Fabienrortais/cz/openchess-redesign/README.md

# OpenChess PCB redesign

A complete, single-PCB redesign of the OpenChess smart chess board
(https://joojoooo.github.io/OpenChess/) that keeps **100 % firmware
compatibility** with upstream (including the pre-built binaries), while
replacing the hand-wired "plastic PCB" + perfboard with one assembled board.

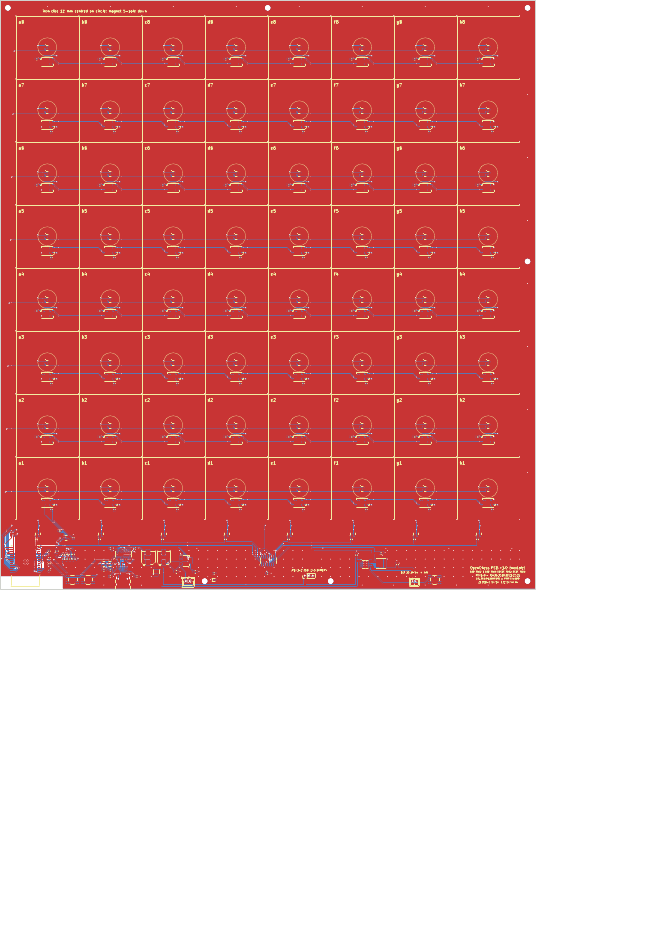
[picture p1: openchess-redesign/docs/img/pcb-overview.png]
overview


## What is on the board

- 8 x 8 squares, **40 mm pitch** (parametric), board 340 x 374 mm, 2 layers.
- Per square: one SOT-23 Hall switch at the square centre (under a 12 mm iron
  disc, silkscreen circle marks it), one WS2812B 5050 LED 9 mm below the
  centre, one 100 nF decoupling cap.
- Column drive: 74HCT595 -> 8 x 1k -> 8 x S8550 PNP high-side switches, one
  under each file, feeding switched +5V up a dedicated trace (same scheme as
  upstream, `SR_INVERT_OUTPUTS = PNP`).
- Rows: sensor open-collector outputs wired-OR per rank, 10k pull-up to 3.3 V,
  straight to the ESP32 GPIOs used by the upstream defaults.
- Controller strip (bottom 42 mm): ESP32-WROOM-32E, CH340C USB-UART with the
  DevKitC auto-reset circuit, RESET/BOOT buttons, AMS1117-3.3, USB-C
  (5 V/3 A, 5.1k CC pull-downs, 3 A polyfuse), optional JST-XH 5 V/4 A input,
  2 x 470 uF bulk, 74AHCT1G125 level shifter for the LED data.
- Power distribution: a 4 mm +5V bus along the strip (B.Cu) and a 2 mm vertical
  +5V bus per file; GND pours on both layers stitched with vias at every square
  corner.
- GPIO map = upstream defaults, so the firmware needs no changes:
  LED IO32, SR SER IO33, SRCLK IO14, RCLK IO26, rows IO4,16,17,18,19,21,22,23.

## Optional battery (both variants)

An IP5306 power-bank IC (Injoinic, LCSC C181692) charges a single Li-ion /
LiPo cell from the USB-C input (2.1 A) and boosts it to 5 V (2.4 A max) for
the board. It is selected with the 3-pin jumper **JP1**:

| JP1 | Bus fed from | Use |
|---|---|---|
| 1-2 | fuse output (USB-C or J2 directly) | no battery fitted; U6/L1/C77-C79/J5/SW3 can be left unpopulated |
| 2-3 | IP5306 VOUT (battery boost, pass-through while charging) | battery fitted on J5 (JST-PH 2.0 mm, + on pin 1) |

Without a battery: use the `-nobattery` BOM/CPL files (block unpopulated),
jumper JP1 1-2, and power through USB-C or J2 as on a board without the block.
SW3 is the IP5306 key (short press on, long press off, it also turns off by
itself below about 45 mA, which the ESP32 never reaches). Power budget: the
boost delivers 2.4 A, so with the battery keep the LED brightness moderate
(all 64 LEDs full white need 3.8 A); a 3000 mAh cell runs the board for
roughly 6-8 h of normal play. Set `OPENCHESS_BATTERY=0` before building to
remove the block entirely.

## Two variants

| Variant | Controller | Output folders | Use when |
|---|---|---|---|
| `module` (default) | ESP32-WROOM-32E soldered on the board, CH340C USB-UART, AMS1117-3.3, RESET/BOOT buttons | `hardware/`, `manufacturing/`, `docs/img/` | You want one fully assembled board from JLCPCB/PCBWay. |
| `nodemcu` | Two 19-pin sockets for a plug-in 38-pin ESP32 dev board (NodeMCU-32S, ESP32-DevKitC V4, ...). USB-C is power only; flashing is done through the dev board's own USB. | `hardware-nodemcu/`, `manufacturing-nodemcu/`, `docs/img-nodemcu/` | You already have a NodeMCU / DevKitC. Strip is 56 mm tall (board 340 x 388 mm). |

NodeMCU variant notes:

- The dev board plugs in with its **antenna to the left and USB to the right**
  (silkscreen says so). Bottom-left pin is 3V3, bottom-right pin is 5V; the
  top row carries GND, IO23, IO22, TX, RX, IO21, GND, IO19, IO18, IO5, IO17,
  IO16, IO4, ... which is the pin order of both the NodeMCU-32S and the
  Espressif DevKitC V4. Check the silkscreen of your board: 3V3 and 5V must
  land on those two corner pins. If a signal pin differs, that is harmless:
  every signal GPIO is configurable in the OpenChess WebUI.
- `DEV_ROW_SPACING` in `design.py` is the distance between the two pin rows:
  22.86 mm (0.9") for the NodeMCU-32S, 25.4 mm (1.0") for the DevKitC V4.
  Measure yours centre-to-centre before ordering.
- No copper pour is placed under the antenna end of the dev board.
- Power the board from the USB-C or J2 (5 V/4 A). Powering only through the
  dev board's micro-USB works for testing but its diode limits LED current.

Build one variant with `VARIANTS=nodemcu ./build.sh /path/to/freerouting.jar`
or set `OPENCHESS_VARIANT=nodemcu` when running the tools by hand.

Folder layout:

```
openchess-redesign/
  AUDIT.md           audit of the upstream project
  README.md          this file
  ORDERING.md        how to order at JLCPCB / PCBWay, cost notes, assembly notes
  hardware/          KiCad project of the module variant (+ DRC report); hardware-nodemcu/ for the dev-board variant
  manufacturing/     gerber zip, drill, JLCPCB BOM + CPL, BOM.md, PDFs (manufacturing-nodemcu/ likewise)
  tools/             generators (everything above is produced from design.py)
  docs/img/          previews
  build.sh           regenerate everything
```

## Regenerating / changing the design

Everything is generated from `tools/design.py` (parts, nets, placement) by
Python scripts that drive KiCad's `pcbnew` module and `kicad-cli`.

KiCad versions: the files were produced with KiCad 7.0.11 (the version
installable in the build container) and use the KiCad 7 file format, which
KiCad 8, 9 and 10 open directly and migrate on save. The scripts detect the
installed version (library paths, API differences, `kicad-cli pcb drc` on 8+)
so you can rebuild with your current KiCad 10 install; the first save from
KiCad 10 will convert the project to the KiCad 10 format.
The matrix routing is scripted; only the controller strip is auto-routed with
Freerouting.

```sh
sudo apt install kicad kicad-symbols kicad-footprints xvfb default-jre   # or any KiCad 8/9/10 install
# Freerouting 1.9.0 jar from https://github.com/freerouting/freerouting/releases
./build.sh /path/to/freerouting.jar
```

Things you will most likely want to change, all at the top of `design.py`:

| Parameter | Default | Note |
|---|---|---|
| `PITCH` | 40.0 mm | Square pitch. 33.33 matches the upstream LED-strip pitch; 45-50 mm for club-size pieces. Board size follows. |
| `SENSOR` | HX3144ESO, pins VCC=1 OUT=2 GND=3 | **Check the datasheet of the exact part you order**; SOT-23 "44E" parts differ between vendors. Any continuous-time open-collector Hall switch in SOT-23 works. |
| `GPIO` | upstream defaults | Only change if you also change the firmware pin config. |
| `STRIP_H`, `MARGIN` | 42 / 10 mm | Controller strip height, grid margin. |

The build verifies the schematic netlist against the model
(`tools/verify_netlist.py`), runs DRC (`tools/drc.py`) and writes
`hardware/openchess-board_drc.rpt`. Opening the project in KiCad and running
"Update PCB from schematic" should report nothing to change.

## Firmware setup on this board

1. Flash the upstream firmware (web flasher or PlatformIO) over the USB-C port
   (CH340C, hold BOOT if needed; the auto-reset circuit normally handles it).
2. In the WebUI "GPIO" section keep the defaults and set the shift-register
   output type to **PNP**.
3. Run the calibration (serial monitor, 115200 baud) once: it learns the LED
   order and the row/column mapping.

## Printable enclosure

`enclosure/enclosure.scad` (OpenSCAD) builds a tray, a 4-piece top plate and a
2-piece controller-strip cover from the same parameters as the PCB
(`tools/gen_enclosure.py` writes `enc_params.scad` and renders the STLs into
`enclosure/stl/` for the module variant and `enclosure/stl-nodemcu/` for the
NodeMCU variant). Every piece is under 175 x 195 mm, so all fit a 256 mm bed
(Bambu A1 or similar):

| Part | Pieces | Print orientation / notes |
|---|---|---|
| `top_q00`, `top_q10`, `top_q01`, `top_q11` | 4 quadrants of the playing surface, 4 mm thick | Print playing face DOWN on the bed: the 12.4 mm iron-disc pockets and 9 mm LED pockets then open upwards and need no supports; 0.8 mm skin stays above each LED. Light/white filament lets the LEDs shine through. Grooves mark the squares, coordinates are engraved in the margins. |
| `tray_00` .. `tray_11` | 4 pieces of the base tray | Flat, no supports. M3 screws go up through the countersunk floor holes into the top plate. |
| `cover_0`, `cover_1` | 2 halves of the strip cover | Print top down. Openings for USB-C (in the tray wall), J2 cable, buttons/LED (module) or the dev board's USB (NodeMCU). |

Glue the quadrant joints (they fall on square edges) or add tape underneath.
Iron discs are glued into the pockets from below; magnets go in the pieces
with the S pole down, as upstream.

## Mechanical notes

- Top plate: anything 3-6 mm thick with a 12.2 mm x 1.2 mm pocket for the iron
  disc centred on each square and a window/diffuser over the LED (9 mm below
  centre). Four 160 x 160 mm printed quadrants fit a 256 mm printer bed.
- The ESP32 antenna overhangs the bottom edge by 6 mm with a copper keep-out
  around it; leave that area of the enclosure free of metal.
- Mounting holes: 7 x M3.

## DRC status

Both variants pass KiCad DRC with 0 errors and 0 unconnected items
(`hardware*/openchess-board*_drc.rpt`). The remaining entries in the reports
are warnings: "library footprint" notices (the headless build has no
fp-lib-table), silkscreen overlaps of reference designators, and a few
"track dangling" notes where the autorouter joined a pre-routed stub mid-way.

Build pipeline per variant: `gen_sch.py` -> `verify_netlist.py` -> `gen_pcb.py`
(scripted matrix routing + pre-routed power/USB/ground stubs) -> `route.py`
(Freerouting for the strip, own `.ses` importer) -> `gnd_repair.py` (adds vias
for ground pour islands, bridges split ground clusters) -> `drc.py` ->
`export.py`. `reroute_nets.py NET...` locks everything else and lets the
router redo single nets.

## Known limitations / to verify

- LCSC numbers were filled from memory and are flagged; verify each one in
  the JLCPCB parts library before ordering (see `ORDERING.md`).
- Rotations in the CPL follow KiCad's convention; check the JLCPCB placement
  preview and rotate SOT-23 / SOIC parts if their preview shows pin 1 wrong.
- 2-layer power distribution is sized for about 4 A total LED current; keep
  the firmware brightness sensible or feed 5 V through J2.
