Fabienrortais/cz/openchess-redesign/docs/img-nodemcu/pcb-controller-strip.png

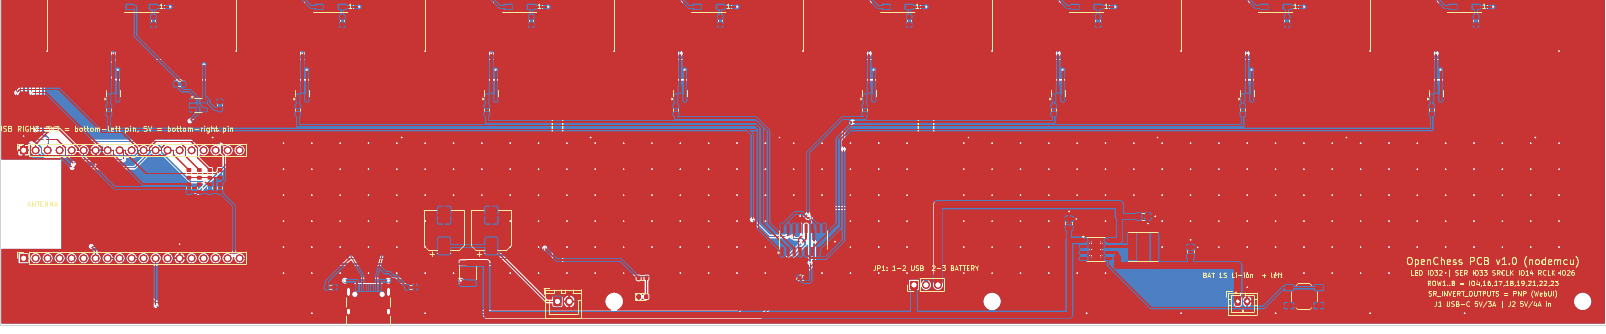
openchess-redesign/docs/img-nodemcu/pcb-controller-strip.png
