Fabienrortais/cz/openchess-redesign/docs/img-nodemcu/pcb-overview.png

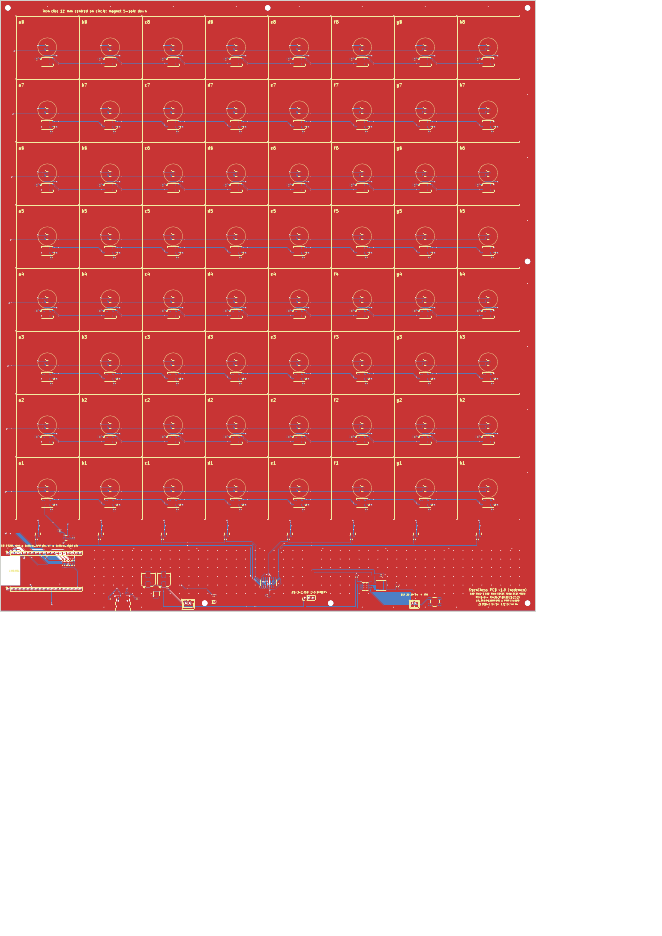
openchess-redesign/docs/img-nodemcu/pcb-overview.png
