Fabienrortais/cz/openchess-redesign/docs/img-nodemcu/pcb-square-detail.png

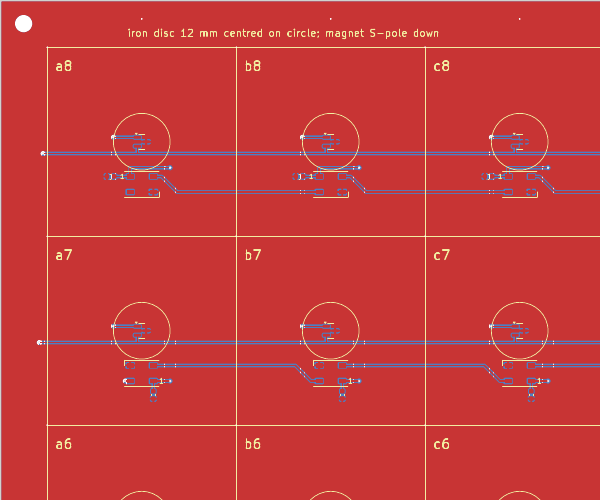
openchess-redesign/docs/img-nodemcu/pcb-square-detail.png
