Fabienrortais/cz/openchess-redesign/docs/img-nodemcu/schematic.png

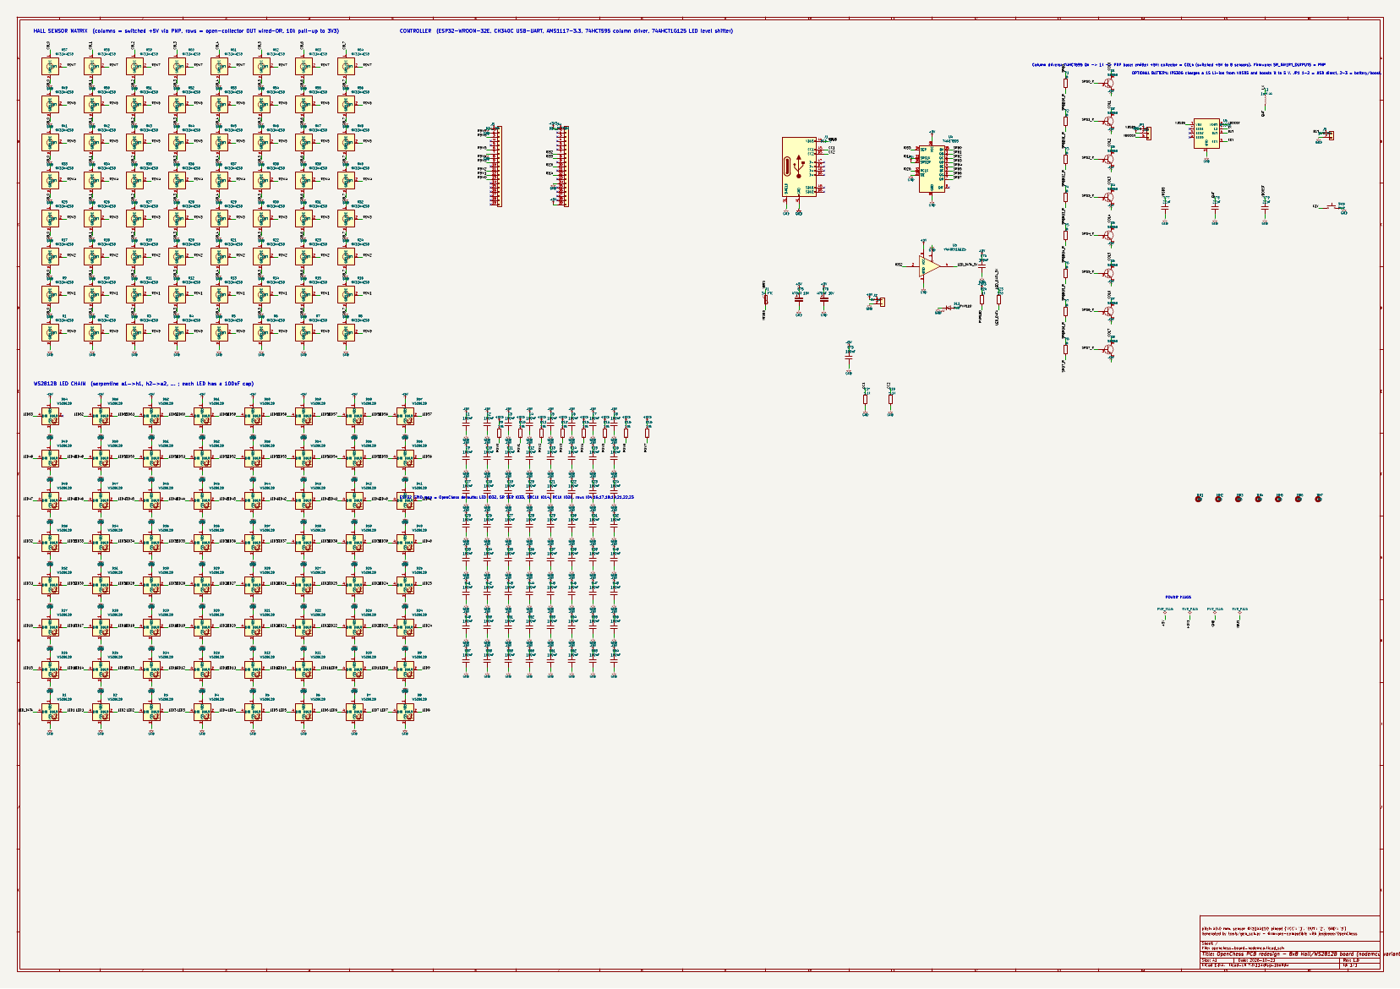
openchess-redesign/docs/img-nodemcu/schematic.png
