Fabienrortais/cz/openchess-redesign/docs/img/pcb-controller-strip.png

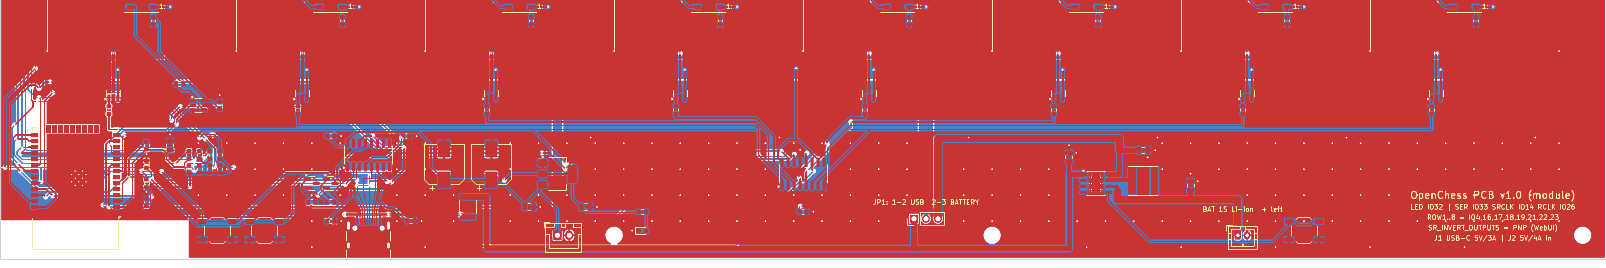
openchess-redesign/docs/img/pcb-controller-strip.png
