Fabienrortais/cz/openchess-redesign/manufacturing-nodemcu/BOM.md

# Bill of materials (generated by tools/export.py)

LCSC numbers marked (verify) were not confirmed on jlcpcb.com; the OPTIONAL battery block lines can be left unpopulated (see ORDERING.md).

| Qty | Designators | Value | MPN / note | Footprint | LCSC | Description |
|---|---|---|---|---|---|---|
| 64 | H1..H64 (64) | HX3144ESO | HX3144ESO | SOT-23 | C558880 | Hall switch |
| 64 | D1..D64 (64) | WS2812B | WS2812B-B/T | LED_WS2812B_PLCC4_5.0x5.0mm_P3.2mm | C2761795 | RGB LED |
| 64 | C1..C64 (64) | 100nF | CL10B104KB8NNNC | C_0603_1608Metric | C14663 | LED decoupling |
| 1 | J3 | DEV_TOP | 1x19 female header 2.54 mm | PinSocket_1x19_P2.54mm_Vertical | TBD | Dev board socket, top row (GND,23,22,TX,RX,21,GND,19,18,5,17,16,4,0,2,15,SD1,SD0,CLK) |
| 1 | J4 | DEV_BOTTOM | 1x19 female header 2.54 mm | PinSocket_1x19_P2.54mm_Vertical | TBD | Dev board socket, bottom row (3V3,EN,VP,VN,34,35,32,33,25,26,27,14,12,GND,13,SD2,SD3,CMD,5V) |
| 8 | R9..R16 (8) | 10k |  | R_0603_1608Metric | C25804 | ROW0 pull-up |
| 1 | U5 | 74AHCT1G125 | SN74AHCT1G125DBVR | SOT-23-5 | C7484 | WS2812B data level shifter |
| 2 | C74,C73 | 100nF |  | C_0603_1608Metric | C14663 | U5 decoupling |
| 1 | R23 | 330 | 330R 0603 (verify C23138) | R_0603_1608Metric | C23138 | LED data series |
| 1 | J1 | USB-C | TYPE-C-31-M-12 | USB_C_Receptacle_HRO_TYPE-C-31-M-12 | C165948 | USB-C receptacle 16P |
| 2 | R17,R18 | 5.1k |  | R_0603_1608Metric | C23186 | USB CC1 pull-down |
| 1 | F1 | 3A PTC | BSMD1812-300-16V (BHFUSE) or ASMD1812-300 C135366 | Fuse_1812_4532Metric | C883162 | Resettable fuse 3A hold (USB path) |
| 1 | U6 | IP5306 | IP5306 | HSOP-8-1EP_3.9x4.9mm_P1.27mm_EP2.41x3.1mm_ThermalVias | C181692 | OPTIONAL battery block: Li-ion charger (2.1 A) + 5 V boost (2.4 A), power-bank IC |
| 1 | L1 | 1uH 4A | SWPA6045S1R0NT (Sunlord) / CKCS6045-1uH/N C354627 / NR6045T1R0N - check land pattern | L_Taiyo-Yuden_NR-60xx | C96955 | OPTIONAL battery block: Boost inductor 1 uH, >= 4 A sat, 6x6 mm |
| 3 | C77,C78,C79 | 22uF |  | C_0805_2012Metric | C45783 | OPTIONAL battery block: IP5306 VIN cap |
| 1 | J5 | BATTERY | B2B-PH-K-S | JST_PH_B2B-PH-K_1x02_P2.00mm_Vertical | C131337 | OPTIONAL battery block: 1S Li-ion / LiPo battery, JST-PH 2.0 mm (+ on pin 1, check your pack!) |
| 1 | JP1 | PWR SEL | 1x3 pin header 2.54 mm + jumper cap | PinHeader_1x03_P2.54mm_Vertical | TBD | OPTIONAL battery block: Power select: 1-2 = USB direct (no battery), 2-3 = battery/boost (IP5306) |
| 1 | SW3 | PWR | TS-1187A-B-A-B | SW_SPST_TL3342 | C318884 | OPTIONAL battery block: IP5306 KEY: short press = boost on, long press = off |
| 1 | J2 | 5V IN | B2B-XH-A | JST_XH_B2B-XH-A_1x02_P2.50mm_Vertical | C158012 | External 5V/4A input (optional, bypasses fuse) |
| 2 | C75,C76 | 470uF 10V | RVT1C471M0810 470uF 16V D8xL10 (verify) | CP_Elec_8x10 | C3341 | 5V bulk capacitor |
| 1 | DL1 | PWR |  | LED_0603_1608Metric | C72043 | Power LED (green) |
| 9 | R24..R8 (9) | 1k |  | R_0603_1608Metric | C21190 | Power LED series |
| 1 | U4 | 74HCT595 | 74HCT595D,112 (Nexperia) | SOIC-16_3.9x9.9mm_P1.27mm | C70468 | Column shift register (HCT = 3.3V-input compatible) |
| 8 | Q1..Q8 (8) | S8550 | S8550 2TY (PNP) | SOT-23 | C2147 | Column a high-side PNP switch |
