Fabienrortais/cz/openchess-redesign/manufacturing-nodemcu/openchess-board-nodemcu-bom-jlcpcb-nobattery.csv

Comment | Designator | Footprint | LCSC Part #
HX3144ESO | H1,H2,H3,H4,H5,H6,H7,H8,H9,H10,H11,H12,H13,H14,H15,H16,H17,H18,H19,H20,H21,H22,H23,H24,H25,H26,H27,H28,H29,H30,H31,H32,H33,H34,H35,H36,H37,H38,H39,H40,H41,H42,H43,H44,H45,H46,H47,H48,H49,H50,H51,H52,H53,H54,H55,H56,H57,H58,H59,H60,H61,H62,H63,H64 | SOT-23 | C558880
WS2812B | D1,D2,D3,D4,D5,D6,D7,D8,D9,D10,D11,D12,D13,D14,D15,D16,D17,D18,D19,D20,D21,D22,D23,D24,D25,D26,D27,D28,D29,D30,D31,D32,D33,D34,D35,D36,D37,D38,D39,D40,D41,D42,D43,D44,D45,D46,D47,D48,D49,D50,D51,D52,D53,D54,D55,D56,D57,D58,D59,D60,D61,D62,D63,D64 | LED_WS2812B_PLCC4_5.0x5.0mm_P3.2mm | C2761795
100nF | C1,C2,C3,C4,C5,C6,C7,C8,C9,C10,C11,C12,C13,C14,C15,C16,C17,C18,C19,C20,C21,C22,C23,C24,C25,C26,C27,C28,C29,C30,C31,C32,C33,C34,C35,C36,C37,C38,C39,C40,C41,C42,C43,C44,C45,C46,C47,C48,C49,C50,C51,C52,C53,C54,C55,C56,C57,C58,C59,C60,C61,C62,C63,C64 | C_0603_1608Metric | C14663
DEV_TOP | J3 | PinSocket_1x19_P2.54mm_Vertical
DEV_BOTTOM | J4 | PinSocket_1x19_P2.54mm_Vertical
10k | R9,R10,R11,R12,R13,R14,R15,R16 | R_0603_1608Metric | C25804
74AHCT1G125 | U5 | SOT-23-5 | C7484
100nF | C74,C73 | C_0603_1608Metric | C14663
330 | R23 | R_0603_1608Metric | C23138
USB-C | J1 | USB_C_Receptacle_HRO_TYPE-C-31-M-12 | C165948
5.1k | R17,R18 | R_0603_1608Metric | C23186
3A PTC | F1 | Fuse_1812_4532Metric | C883162
PWR SEL | JP1 | PinHeader_1x03_P2.54mm_Vertical
5V IN | J2 | JST_XH_B2B-XH-A_1x02_P2.50mm_Vertical | C158012
470uF 10V | C75,C76 | CP_Elec_8x10 | C3341
PWR | DL1 | LED_0603_1608Metric | C72043
1k | R24,R1,R2,R3,R4,R5,R6,R7,R8 | R_0603_1608Metric | C21190
74HCT595 | U4 | SOIC-16_3.9x9.9mm_P1.27mm | C70468
S8550 | Q1,Q2,Q3,Q4,Q5,Q6,Q7,Q8 | SOT-23 | C2147
