Fabienrortais/cz/openchess-redesign/enclosure/stl-nodemcu/openchess-board-nodemcu-top_q01.stl

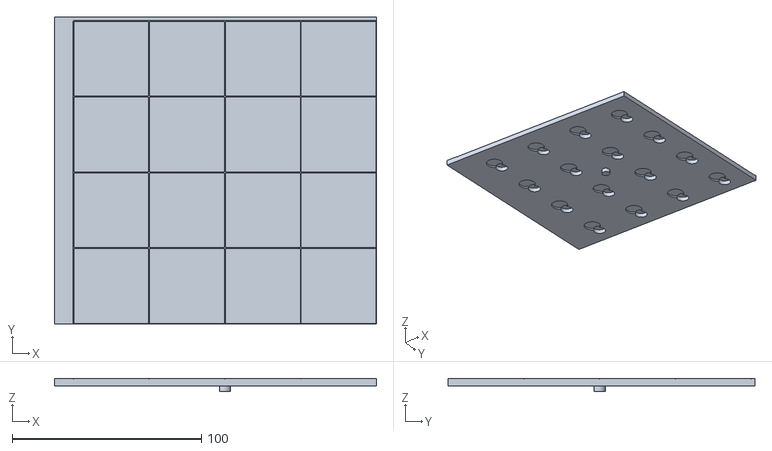
[picture p7: CAD file, 2026-10-21]
openchess-redesign/enclosure/stl-nodemcu/openchess-board-nodemcu-top_q01.stl
170.0 x 162.0 x 7.00
