Fabienrortais/cz/openchess-redesign/enclosure/stl/openchess-board-cover_0.stl

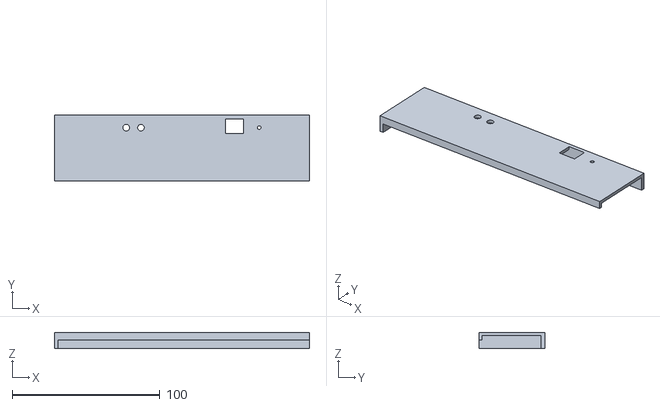
[picture p8: CAD file, 2026-10-21]
openchess-redesign/enclosure/stl/openchess-board-cover_0.stl
172.5 x 44.5 x 11.0
