Fabienrortais/cz/openchess-redesign/enclosure/stl-nodemcu/openchess-board-nodemcu-top_q10.stl

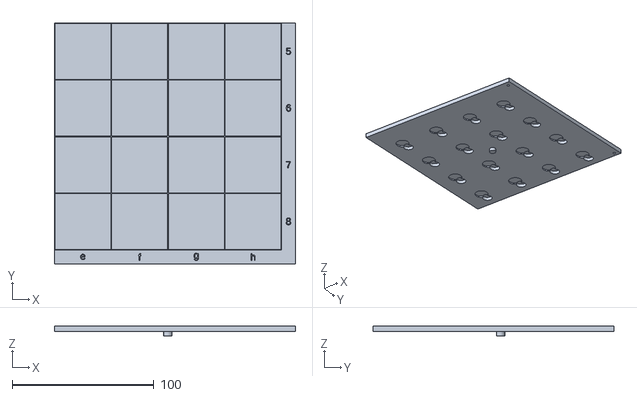
[picture p9: CAD file, 2026-10-21]
openchess-redesign/enclosure/stl-nodemcu/openchess-board-nodemcu-top_q10.stl
170.0 x 170.0 x 7.00
