Fabienrortais/cz/openchess-redesign/enclosure/stl/openchess-board-tray_11.stl

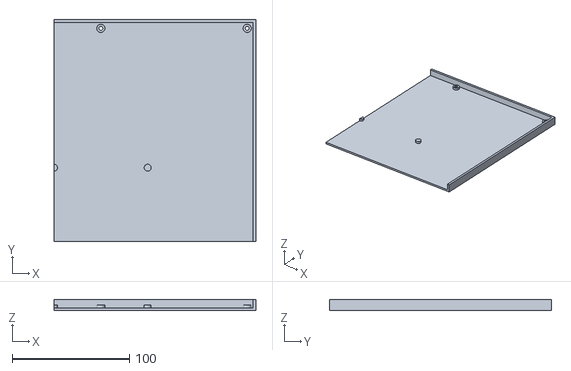
[picture p10: CAD file, 2026-10-21]
openchess-redesign/enclosure/stl/openchess-board-tray_11.stl
172.5 x 189.5 x 9.10
