Fabienrortais/cz/openchess-redesign/enclosure/stl-nodemcu/openchess-board-nodemcu-cover_0.stl

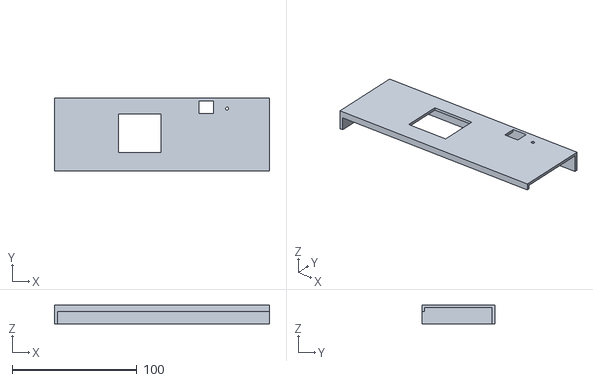
[picture p11: CAD file, 2026-10-21]
openchess-redesign/enclosure/stl-nodemcu/openchess-board-nodemcu-cover_0.stl
172.5 x 58.5 x 15.0
