Fabienrortais/cz/openchess-redesign/enclosure/stl-nodemcu/openchess-board-nodemcu-tray_01.stl

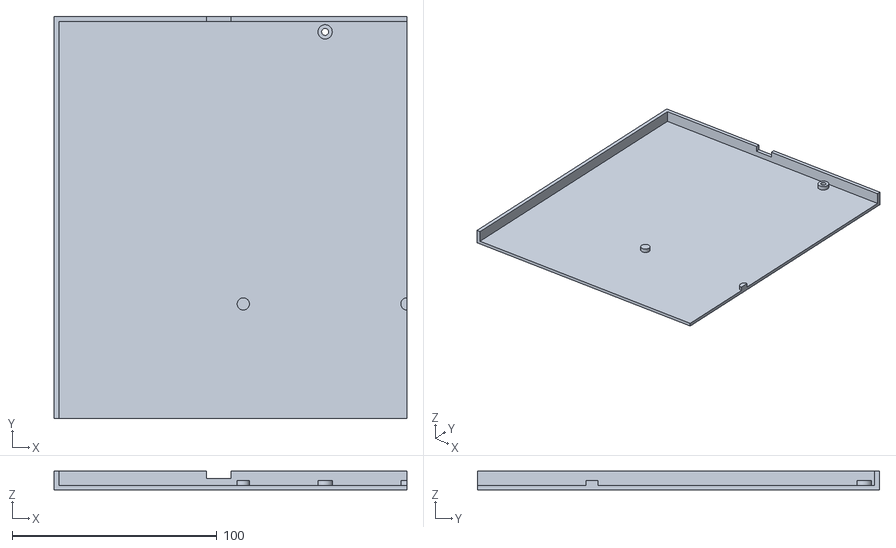
[picture p12: CAD file, 2026-10-21]
openchess-redesign/enclosure/stl-nodemcu/openchess-board-nodemcu-tray_01.stl
172.5 x 196.5 x 9.10
