Fabienrortais/cz/openchess-redesign/enclosure/enc_params.scad

VARIANT = "module";
W = 340.0; H = 374.0; STRIP_Y = 332.0;
PITCH = 40.0; GRID_X0 = 10.0; GRID_Y0 = 10.0; LED_DY = 9.0;
MH = [[5, 5], [170.0, 5], [335.0, 5], [335.0, 166.0], [335.0, 369.0], [210.0, 369.0], [130.0, 369.0]];
J1_X = 78.0; J2_X = 119.25; J2_Y = 369.0;
DL1_X = 136.0; DL1_Y = 368.0;
BATTERY = true;
J5_X = 263.0; J5_Y = 369.0; SW3_X = 276.0; SW3_Y = 368.0; JP1_X = 196.0; JP1_Y = 365.5;
SW1_X = 56.0; SW1_Y = 368.0; SW2_X = 46.0; SW2_Y = 368.0;
ANT_X0 = 4; ANT_X1 = 28;
COVER_INNER_H = 12;
DEV_USB_X0 = 0; DEV_USB_X1 = 0; DEV_USB_Y0 = 0; DEV_USB_Y1 = 0;
