Fabienrortais/cz/openchess-redesign/enclosure/stl-nodemcu/enc_params.scad

VARIANT = "nodemcu";
W = 340.0; H = 388.0; STRIP_Y = 332.0;
PITCH = 40.0; GRID_X0 = 10.0; GRID_Y0 = 10.0; LED_DY = 9.0;
MH = [[5, 5], [170.0, 5], [335.0, 5], [335.0, 166.0], [335.0, 383.0], [210.0, 383.0], [130.0, 383.0]];
J1_X = 78.0; J2_X = 119.25; J2_Y = 383.0;
DL1_X = 136.0; DL1_Y = 382.0;
BATTERY = true;
J5_X = 263.0; J5_Y = 383.0; SW3_X = 276.0; SW3_Y = 382.0; JP1_X = 196.0; JP1_Y = 379.5;
SW1_X = 0; SW1_Y = 0; SW2_X = 0; SW2_Y = 0;
ANT_X0 = 0; ANT_X1 = 0;
COVER_INNER_H = 16;
DEV_USB_X0 = 49.0; DEV_USB_X1 = 83.0; DEV_USB_Y0 = 347.0; DEV_USB_Y1 = 377.86;
