Fabienrortais/cz/(list of files, cad)

Other CAD files:
openchess-redesign/enclosure/stl-nodemcu/openchess-board-nodemcu-top_q11.stl
openchess-redesign/enclosure/stl/openchess-board-top_q01.stl
openchess-redesign/enclosure/stl/openchess-board-cover_1.stl
openchess-redesign/enclosure/stl/openchess-board-top_q10.stl
openchess-redesign/enclosure/stl-nodemcu/openchess-board-nodemcu-tray_11.stl
openchess-redesign/enclosure/stl/openchess-board-tray_10.stl
openchess-redesign/enclosure/stl-nodemcu/openchess-board-nodemcu-tray_00.stl
openchess-redesign/enclosure/stl/openchess-board-top_q00.stl
openchess-redesign/enclosure/stl-nodemcu/openchess-board-nodemcu-top_q00.stl
openchess-redesign/enclosure/stl/openchess-board-top_q11.stl
openchess-redesign/enclosure/stl/openchess-board-tray_00.stl
openchess-redesign/enclosure/stl-nodemcu/openchess-board-nodemcu-tray_10.stl
openchess-redesign/enclosure/stl/openchess-board-tray_01.stl
