Fabienrortais/cz/openchess-redesign/manufacturing-nodemcu/openchess-board-nodemcu-schematic.pdf

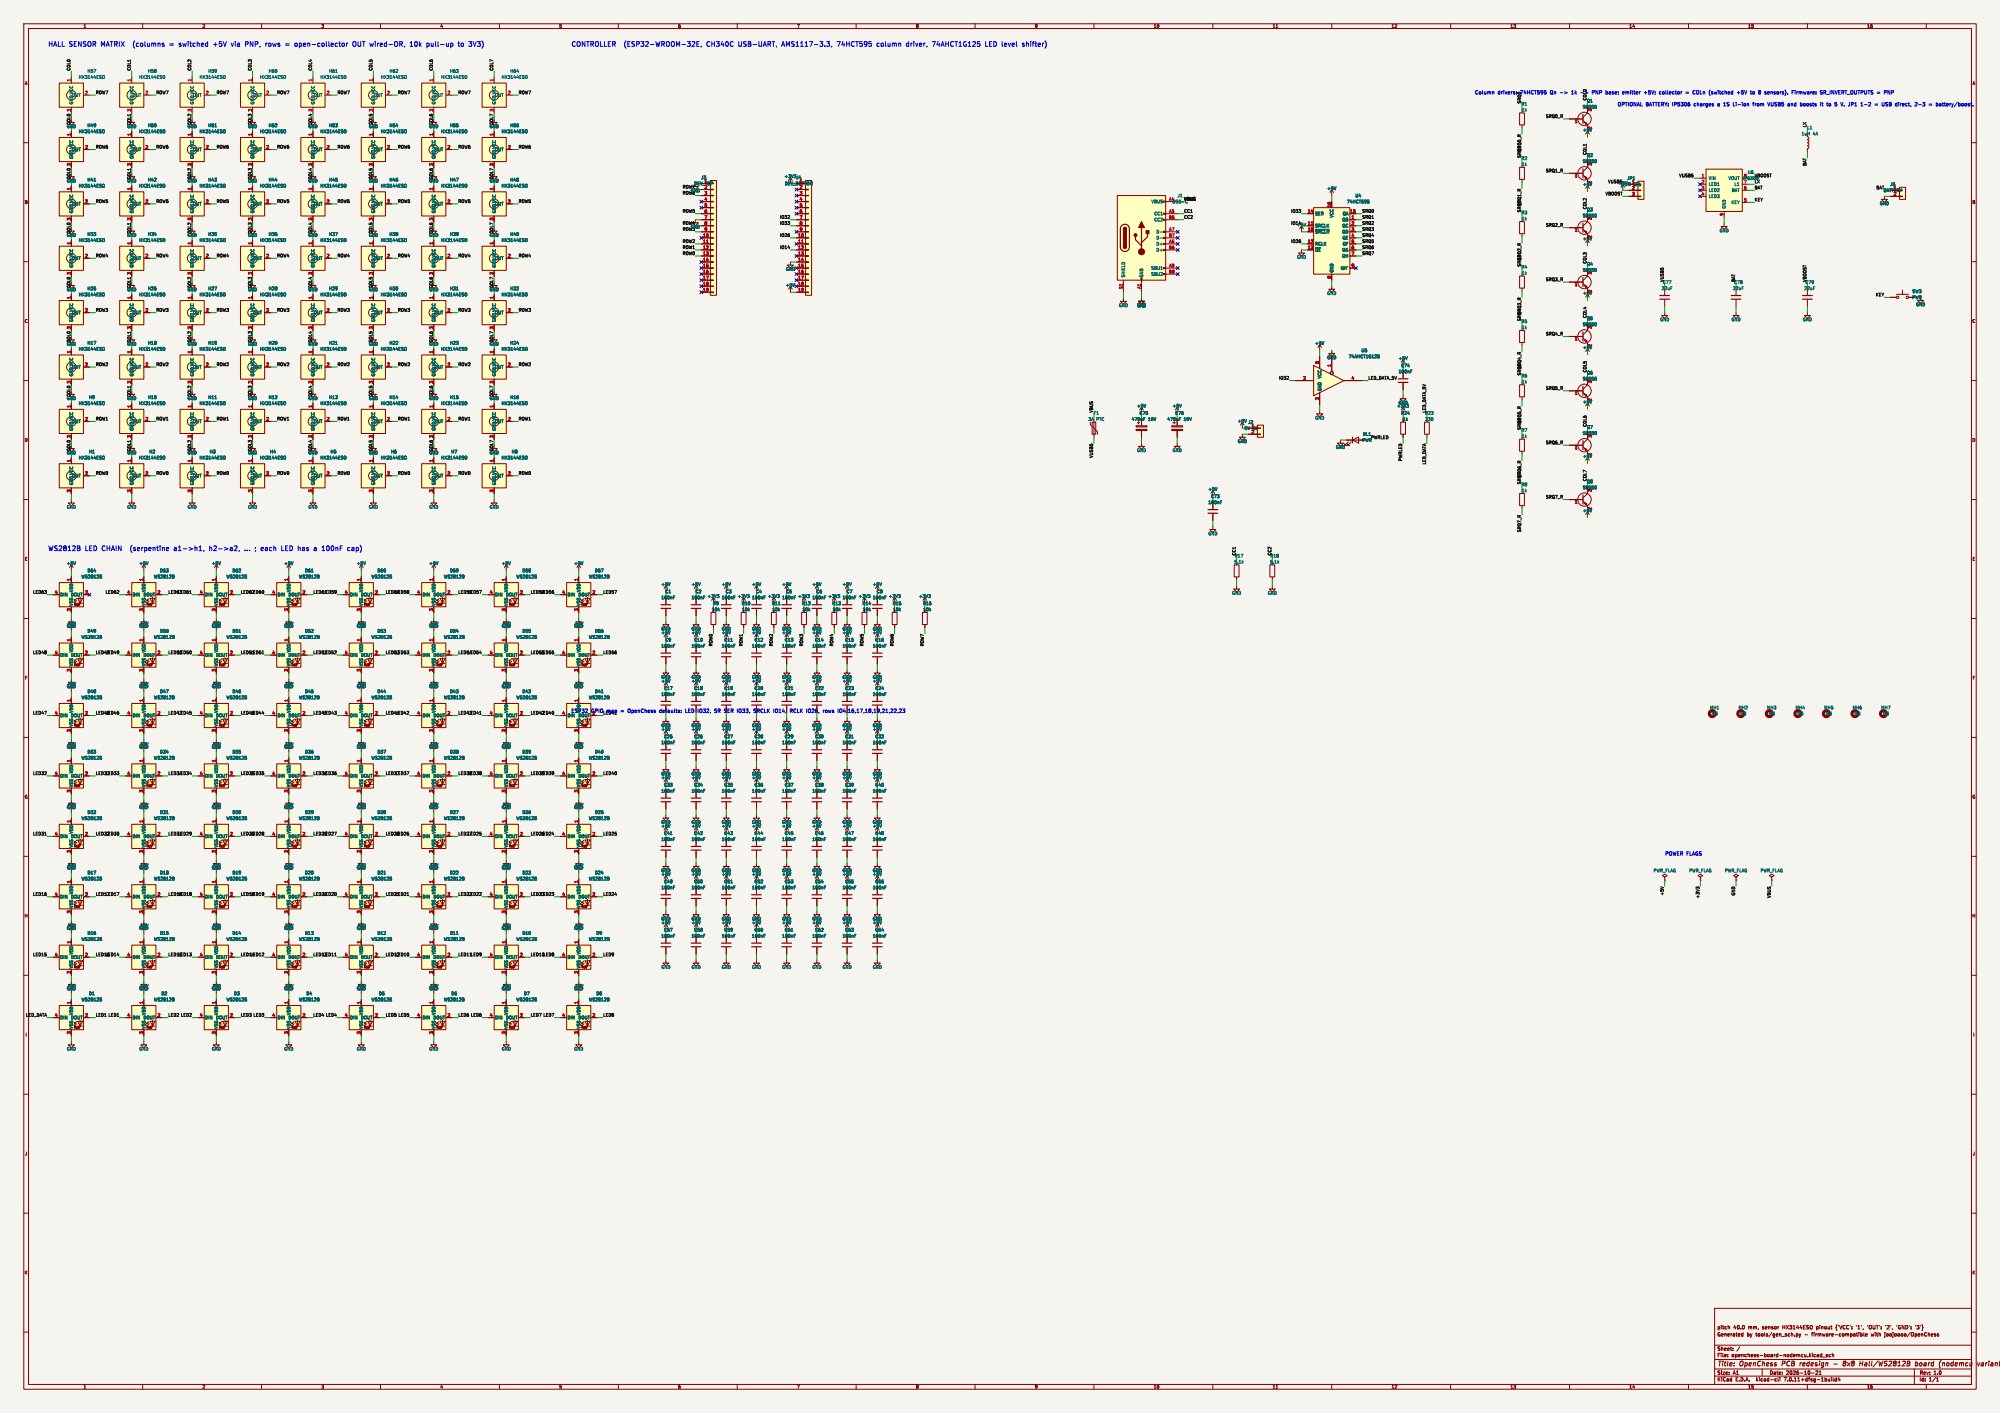
[picture p15: page 1]

3 GND GND GND GND GND

1 DOUT 2 VSS
RGB VDD
ESP32 GPIO map = OpenChess defaults: LED IO32, SR SER IO33, SRCLK IO14, RCLK IO26, rows IO4,16,17,18,19,21,22,23

3 DIN 4 GND +5V GND +5V D30 WS2812B VDD

3 DIN 4 +5V GND GND +5V +5V D17 WS2812B VDD
