Fabienrortais/cz/openchess-redesign/manufacturing-nodemcu/openchess-board-nodemcu-top.pdf

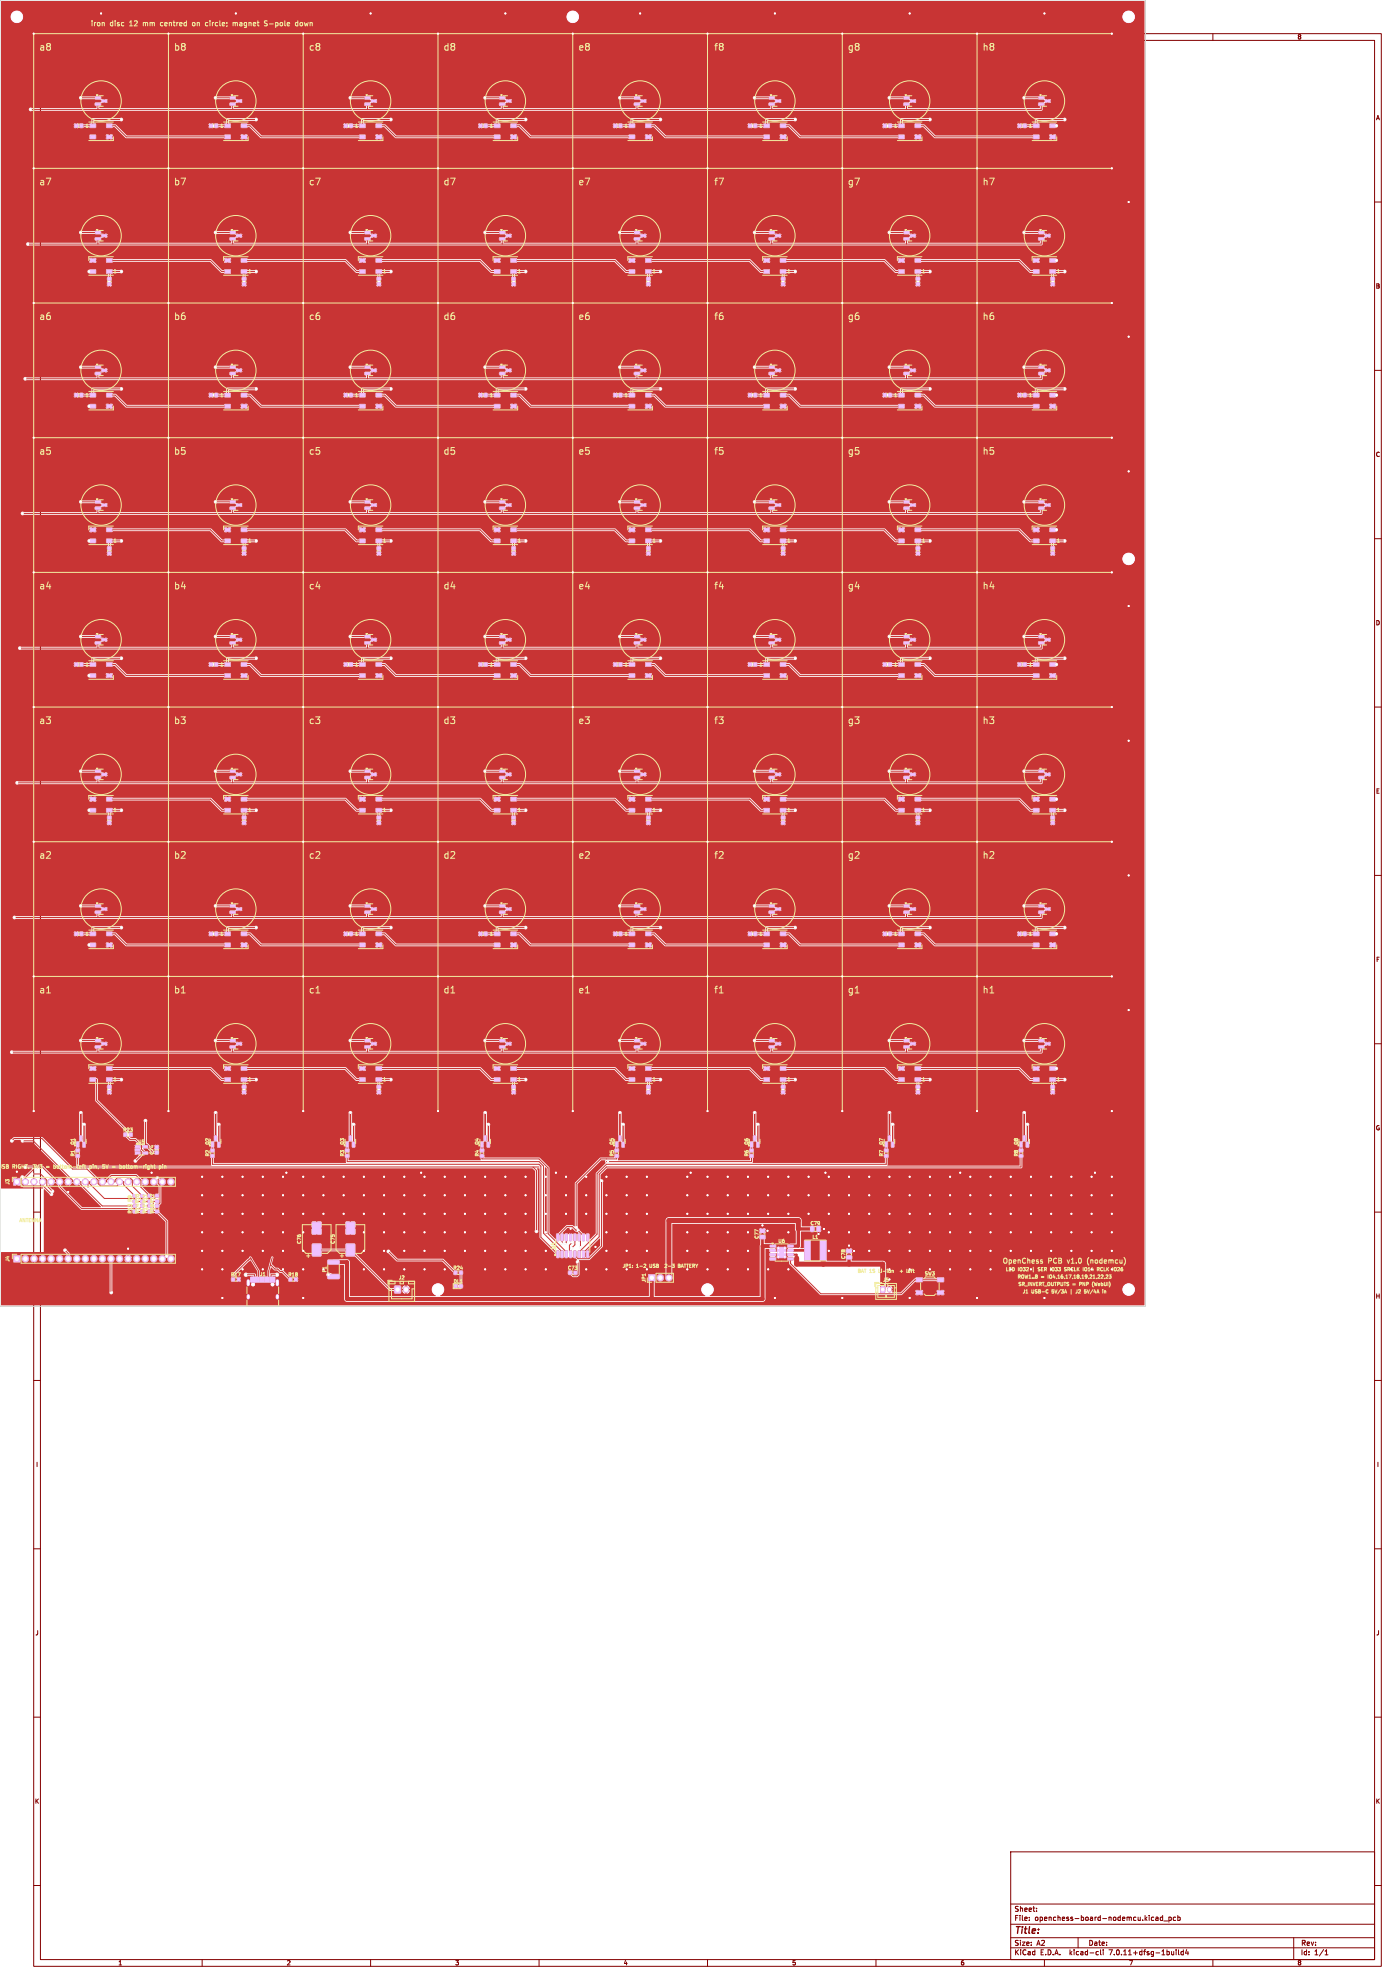
[picture p16: page 1]

Id: 1/1 Title: File: openchess-board-nodemcu.kicad_pcb Sheet:
