Fabienrortais/cz/openchess-redesign/manufacturing/openchess-board-bottom.pdf

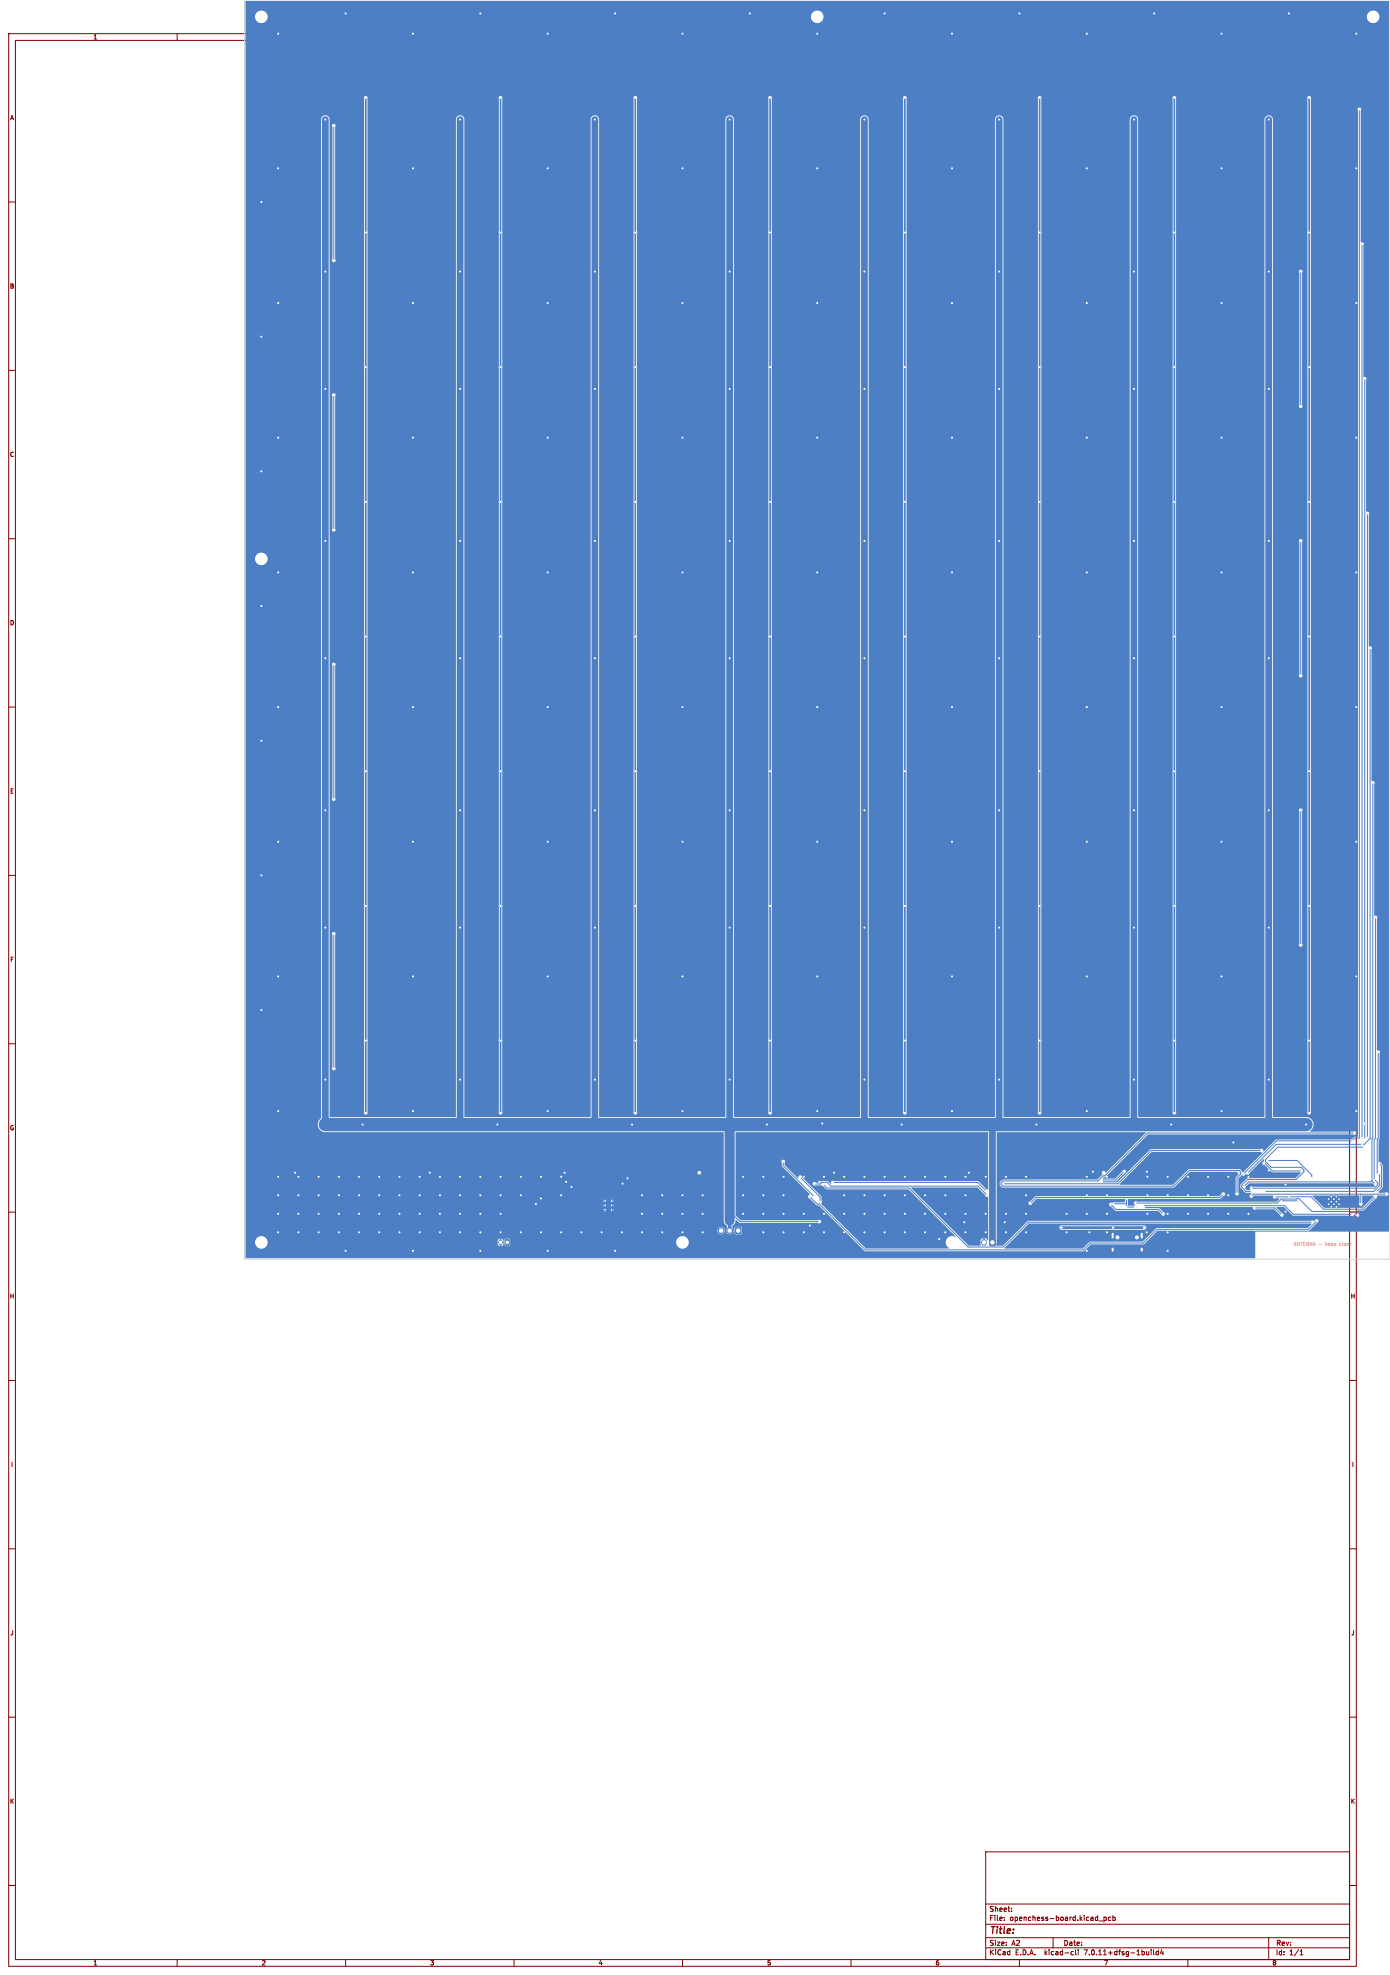
[picture p17: page 1]

Id: 1/1 Title: File: openchess-board.kicad_pcb Sheet:
