Fabienrortais/cz/openchess-redesign/manufacturing/openchess-board-schematic.pdf

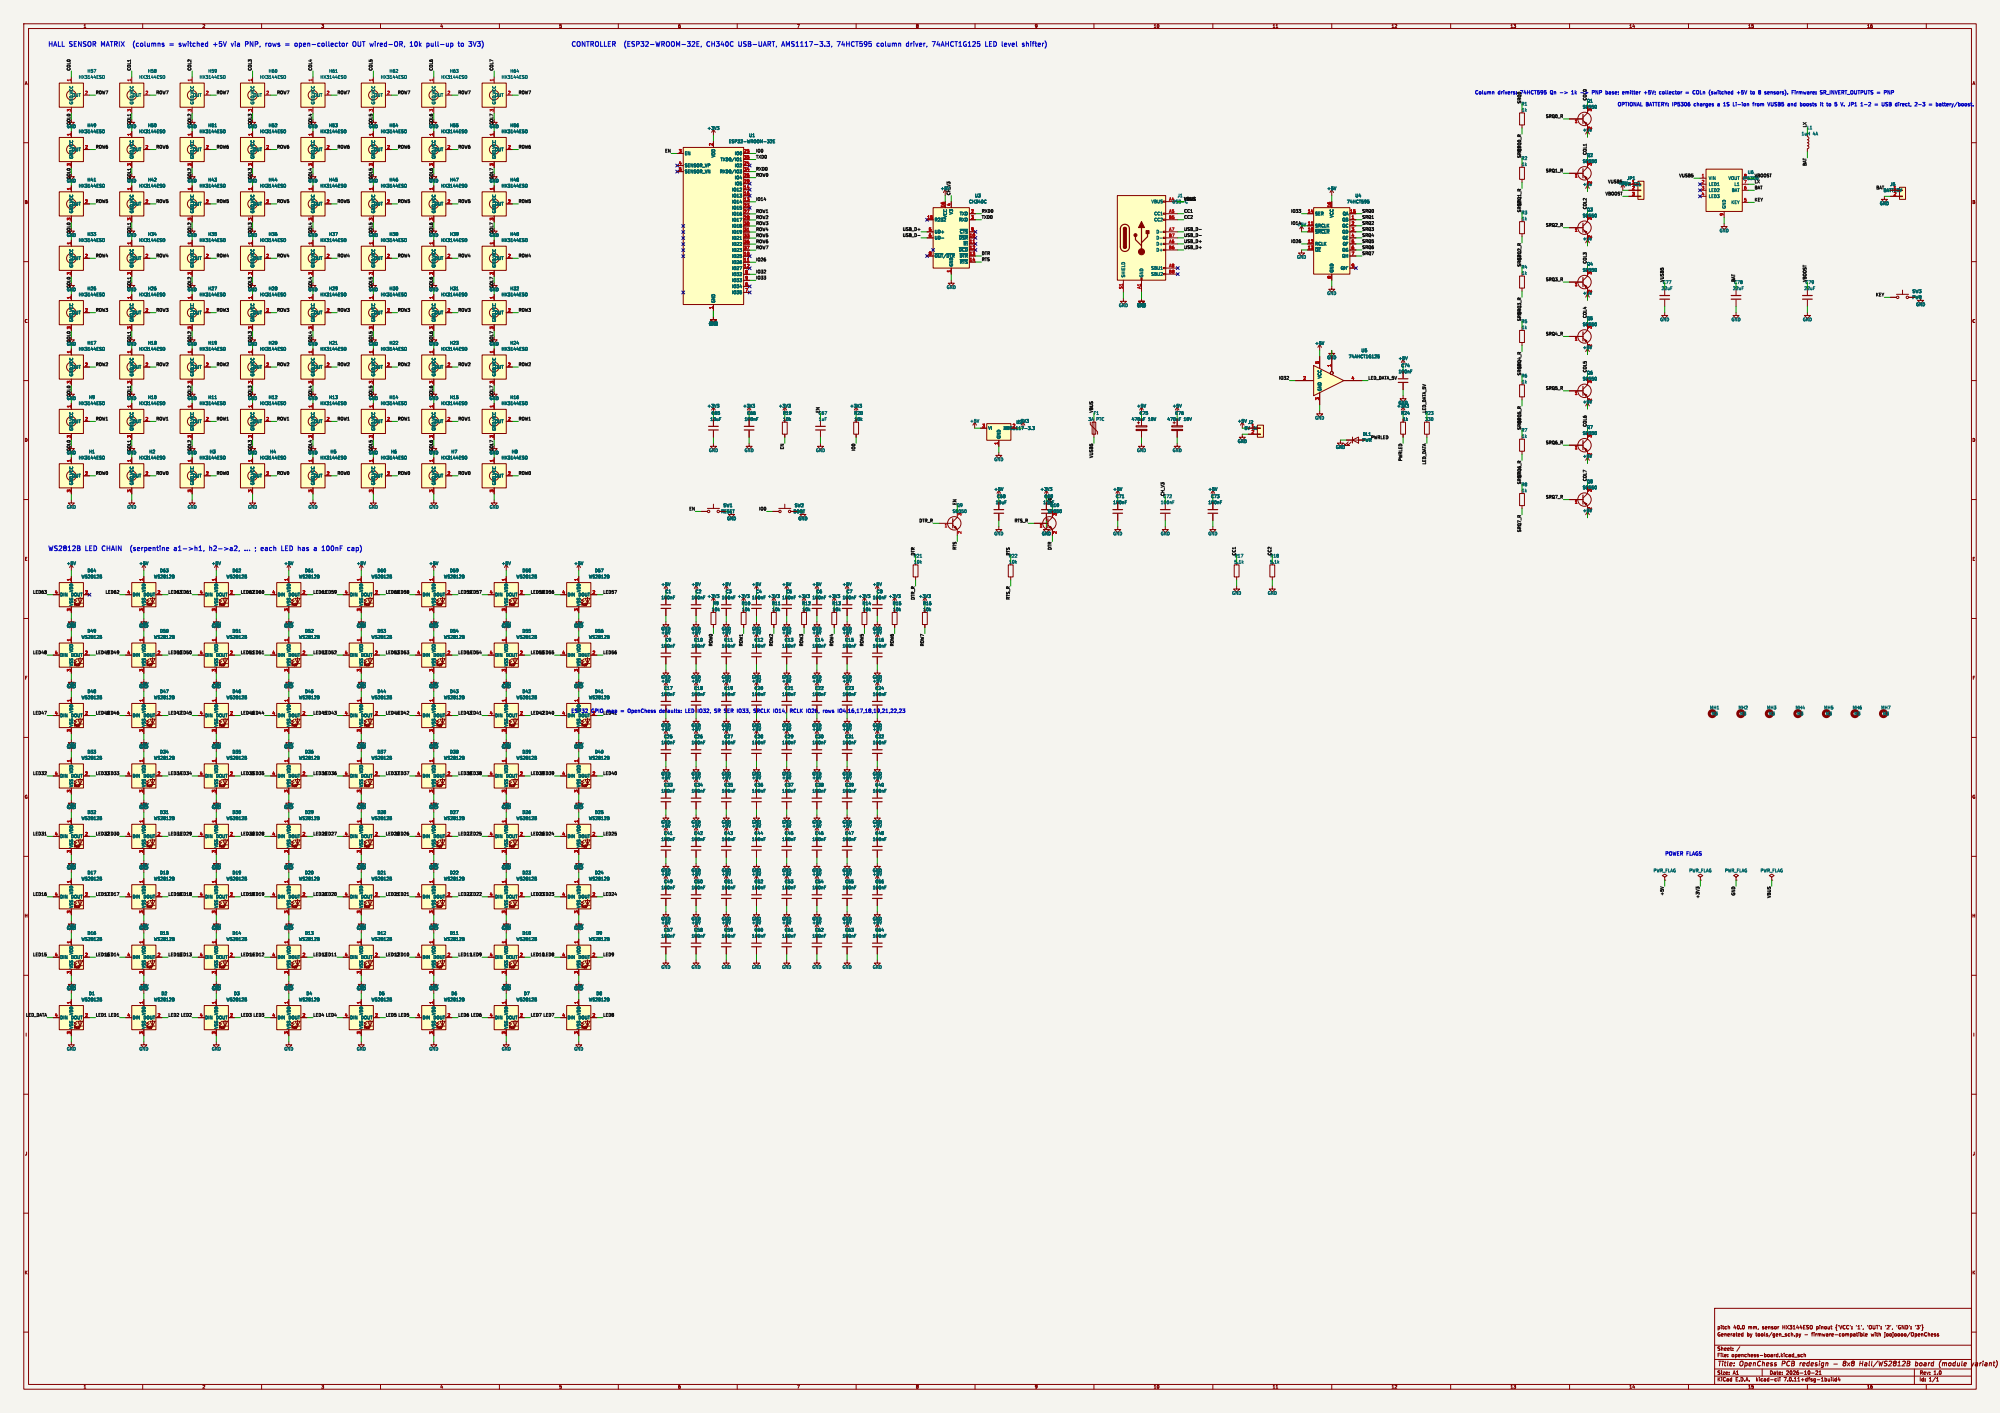
[picture p18: page 1]

3 GND GND GND H55 HX3144ESO VCC

SRQ1 COL0
GND GND GND VCC

1 ~{DSR} 10 ~{RI} 11 ~{DCD} 12 ~{DTR} 13 ~{RTS} 14 R232

2 3 Q9 S8050 GND GND GND GND

3 DIN 4 D41 WS2812B GND +5V GND GND GND GND

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

3 DIN 4 D31 WS2812B GND GND GND

3 DIN 4 GND +5V GND +5V D30 WS2812B VDD

3 DIN 4 +5V GND GND +5V +5V D17 WS2812B VDD
