Fabienrortais/cz/openchess-redesign/manufacturing/openchess-board-top.pdf

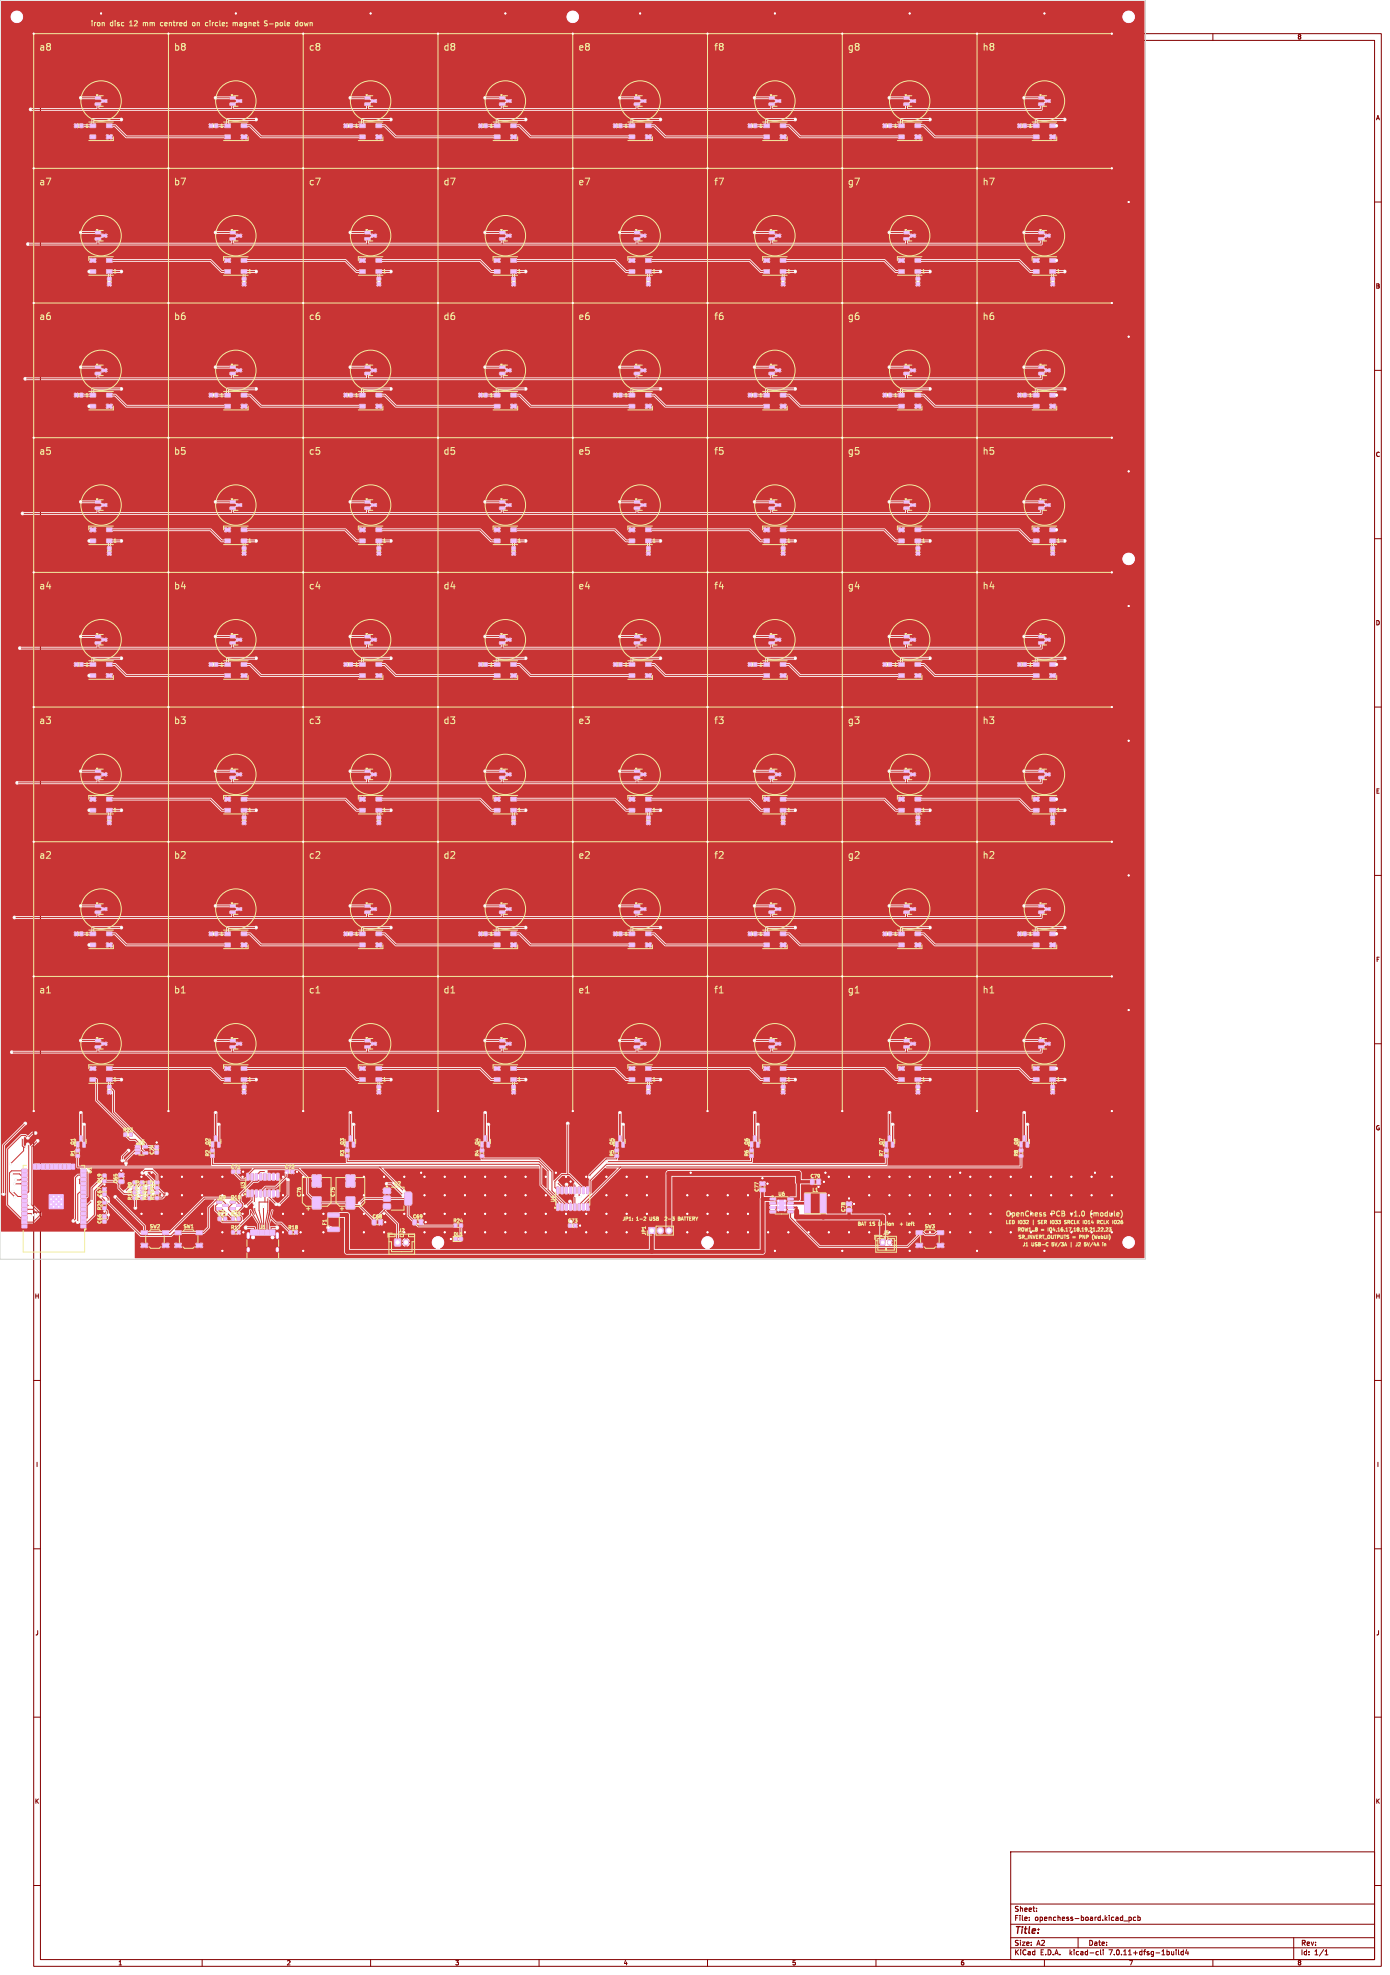
[picture p19: page 1]

LED IO32 | SER IO33 SRCLK IO14 RCLK IO26
ROW1..8 = IO4,16,17,18,19,21,22,23

Id: 1/1 Title: File: openchess-board.kicad_pcb Sheet:
