Fabienrortais/cz/openchess-redesign/hardware/openchess-board.kicad_pcb

## KiCad design openchess-redesign/hardware/openchess-board.kicad_pcb (2026-10-21)

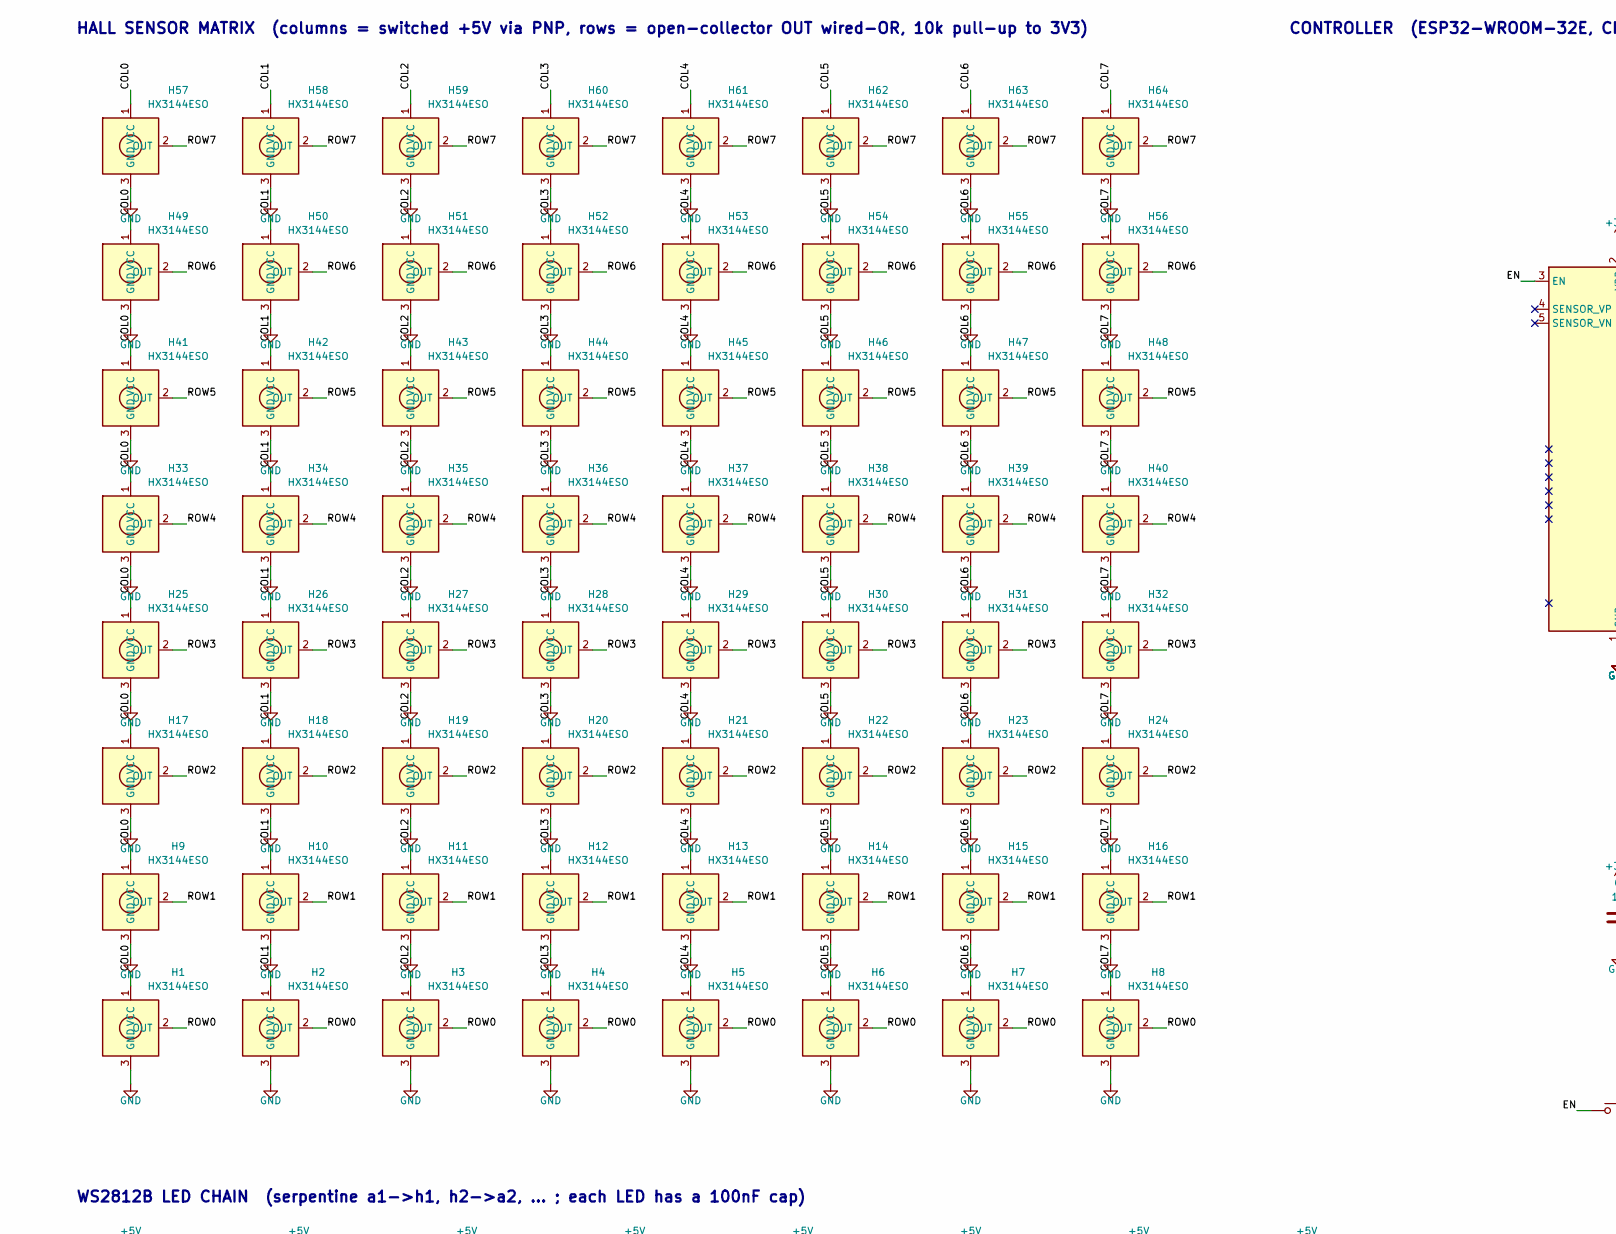
[picture p20: schematic openchess-board.kicad_sch, OpenChess PCB redesign - 8x8 Hall/WS2812B board (module var…, part in row 1, column 1]

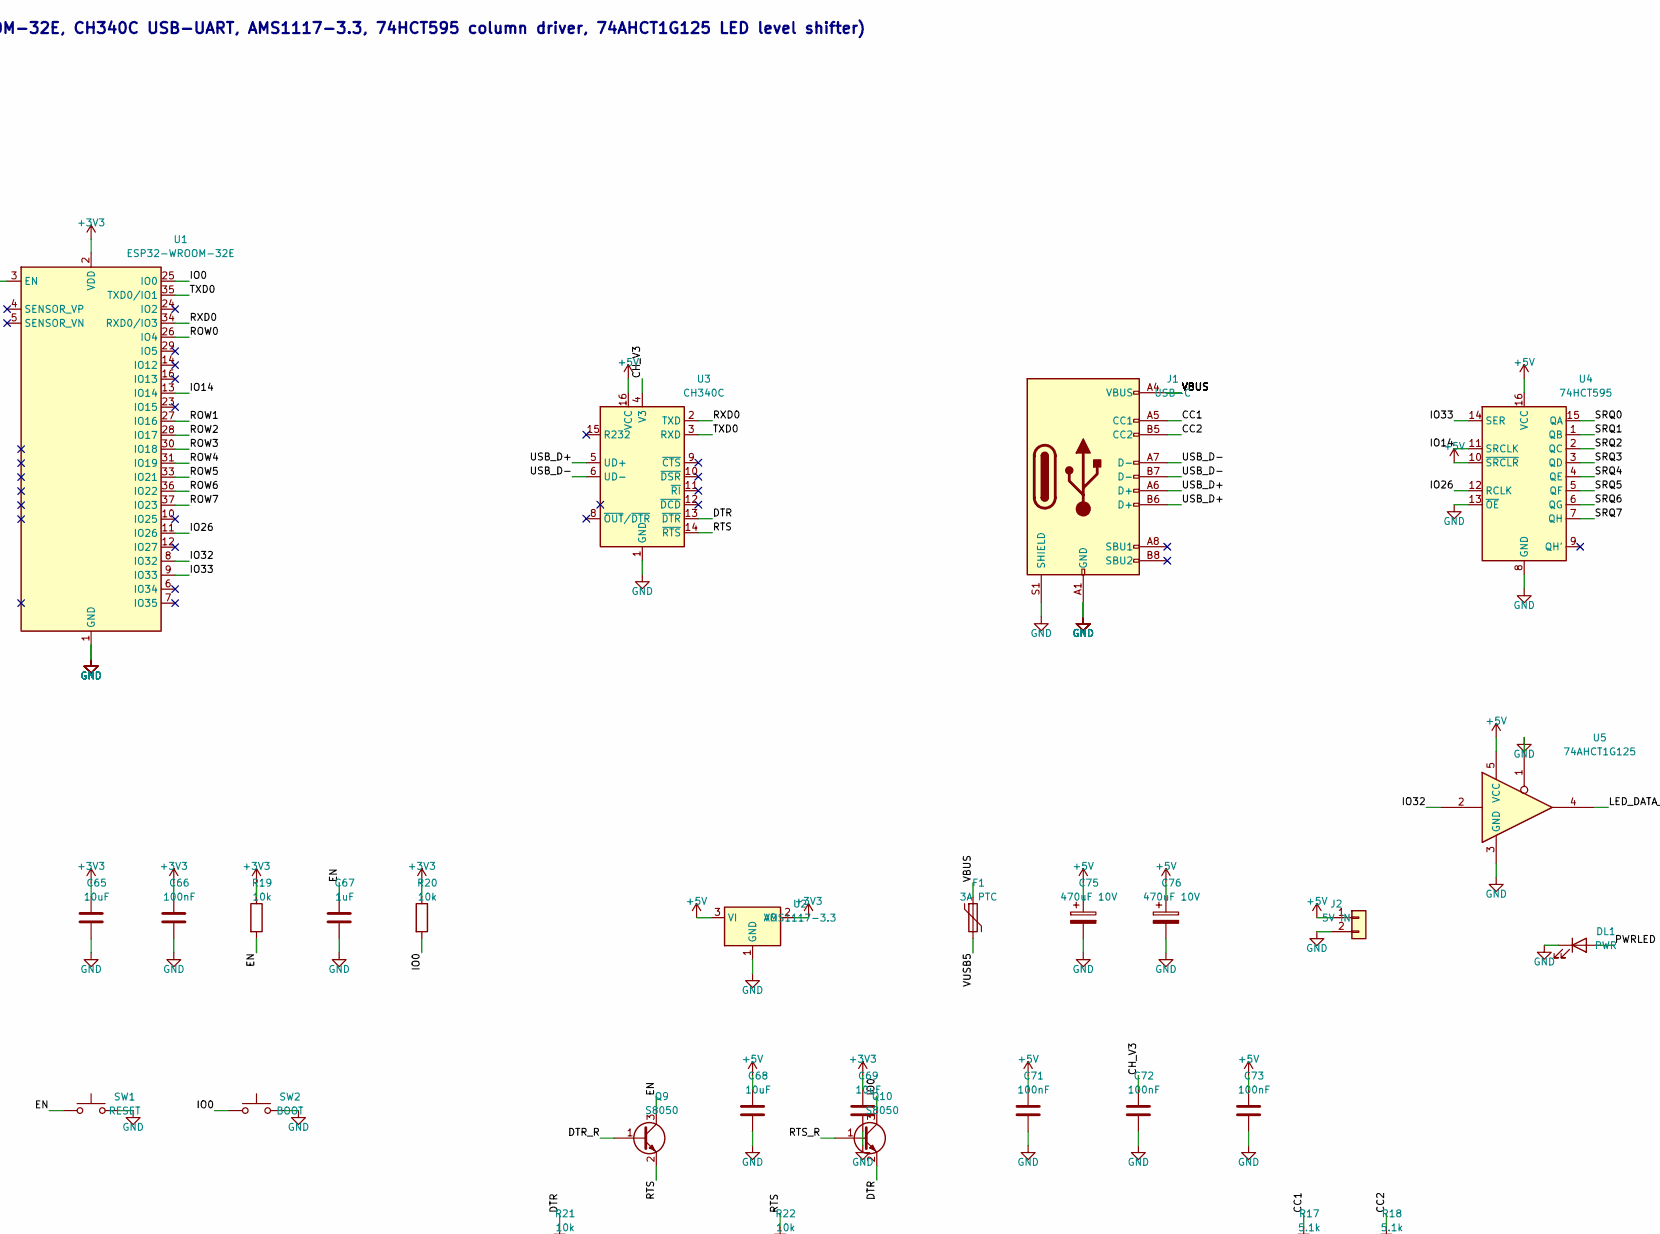
[picture p21: schematic openchess-board.kicad_sch, OpenChess PCB redesign - 8x8 Hall/WS2812B board (module var…, part in row 1, column 2]

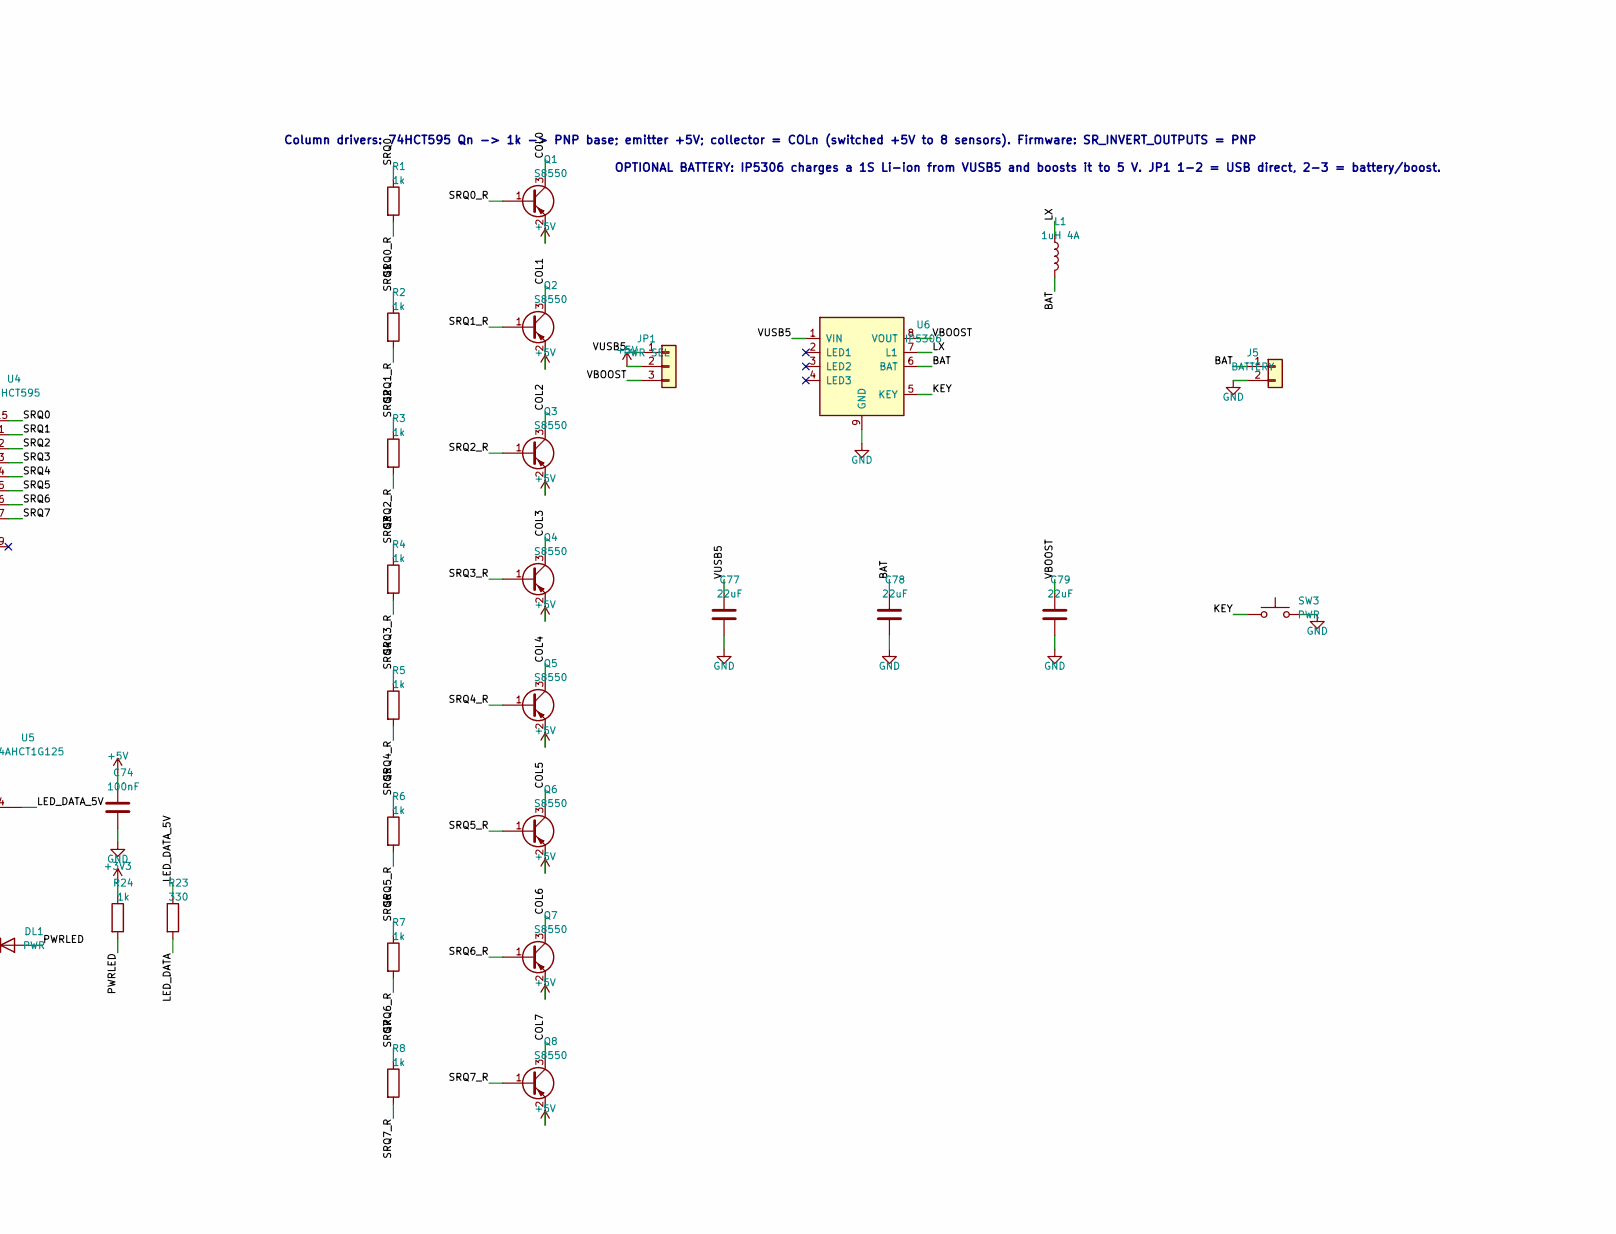
[picture p22: schematic openchess-board.kicad_sch, OpenChess PCB redesign - 8x8 Hall/WS2812B board (module var…, part in row 1, column 3]

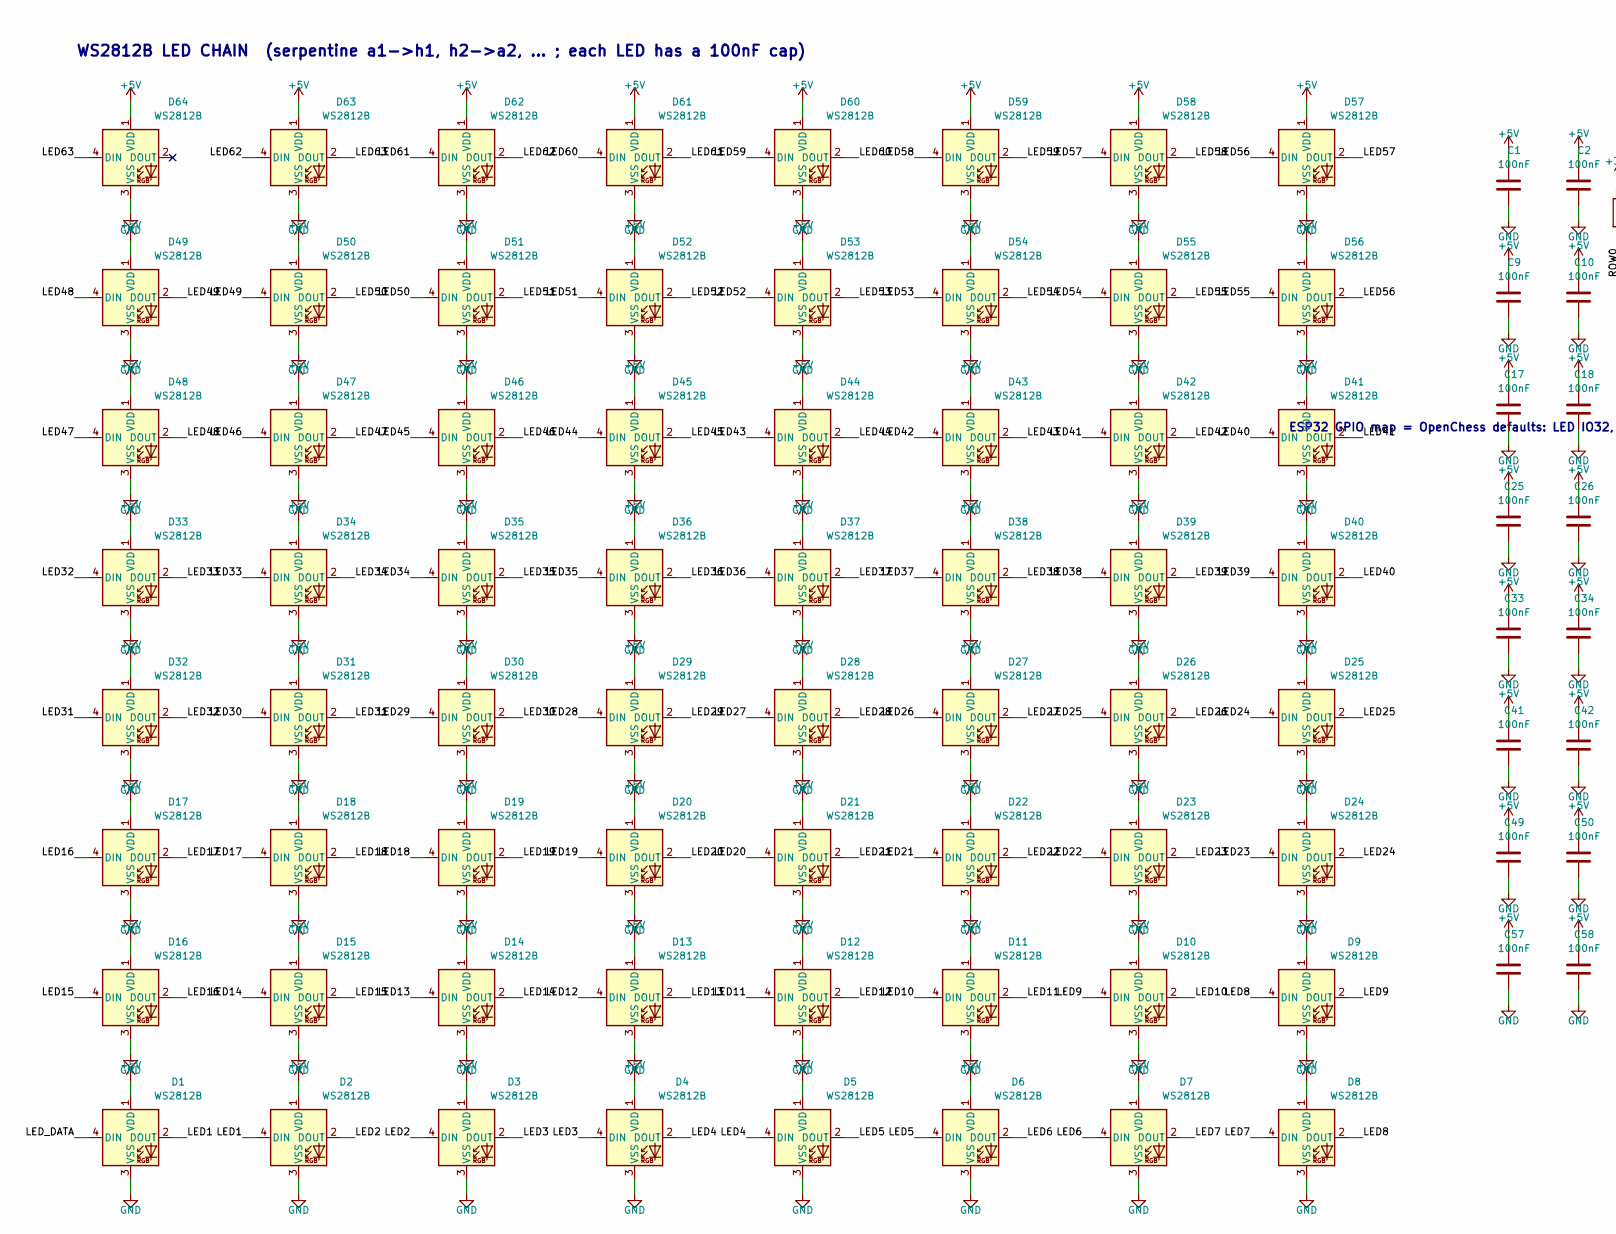
[picture p23: schematic openchess-board.kicad_sch, OpenChess PCB redesign - 8x8 Hall/WS2812B board (module var…, part in row 2, column 1]

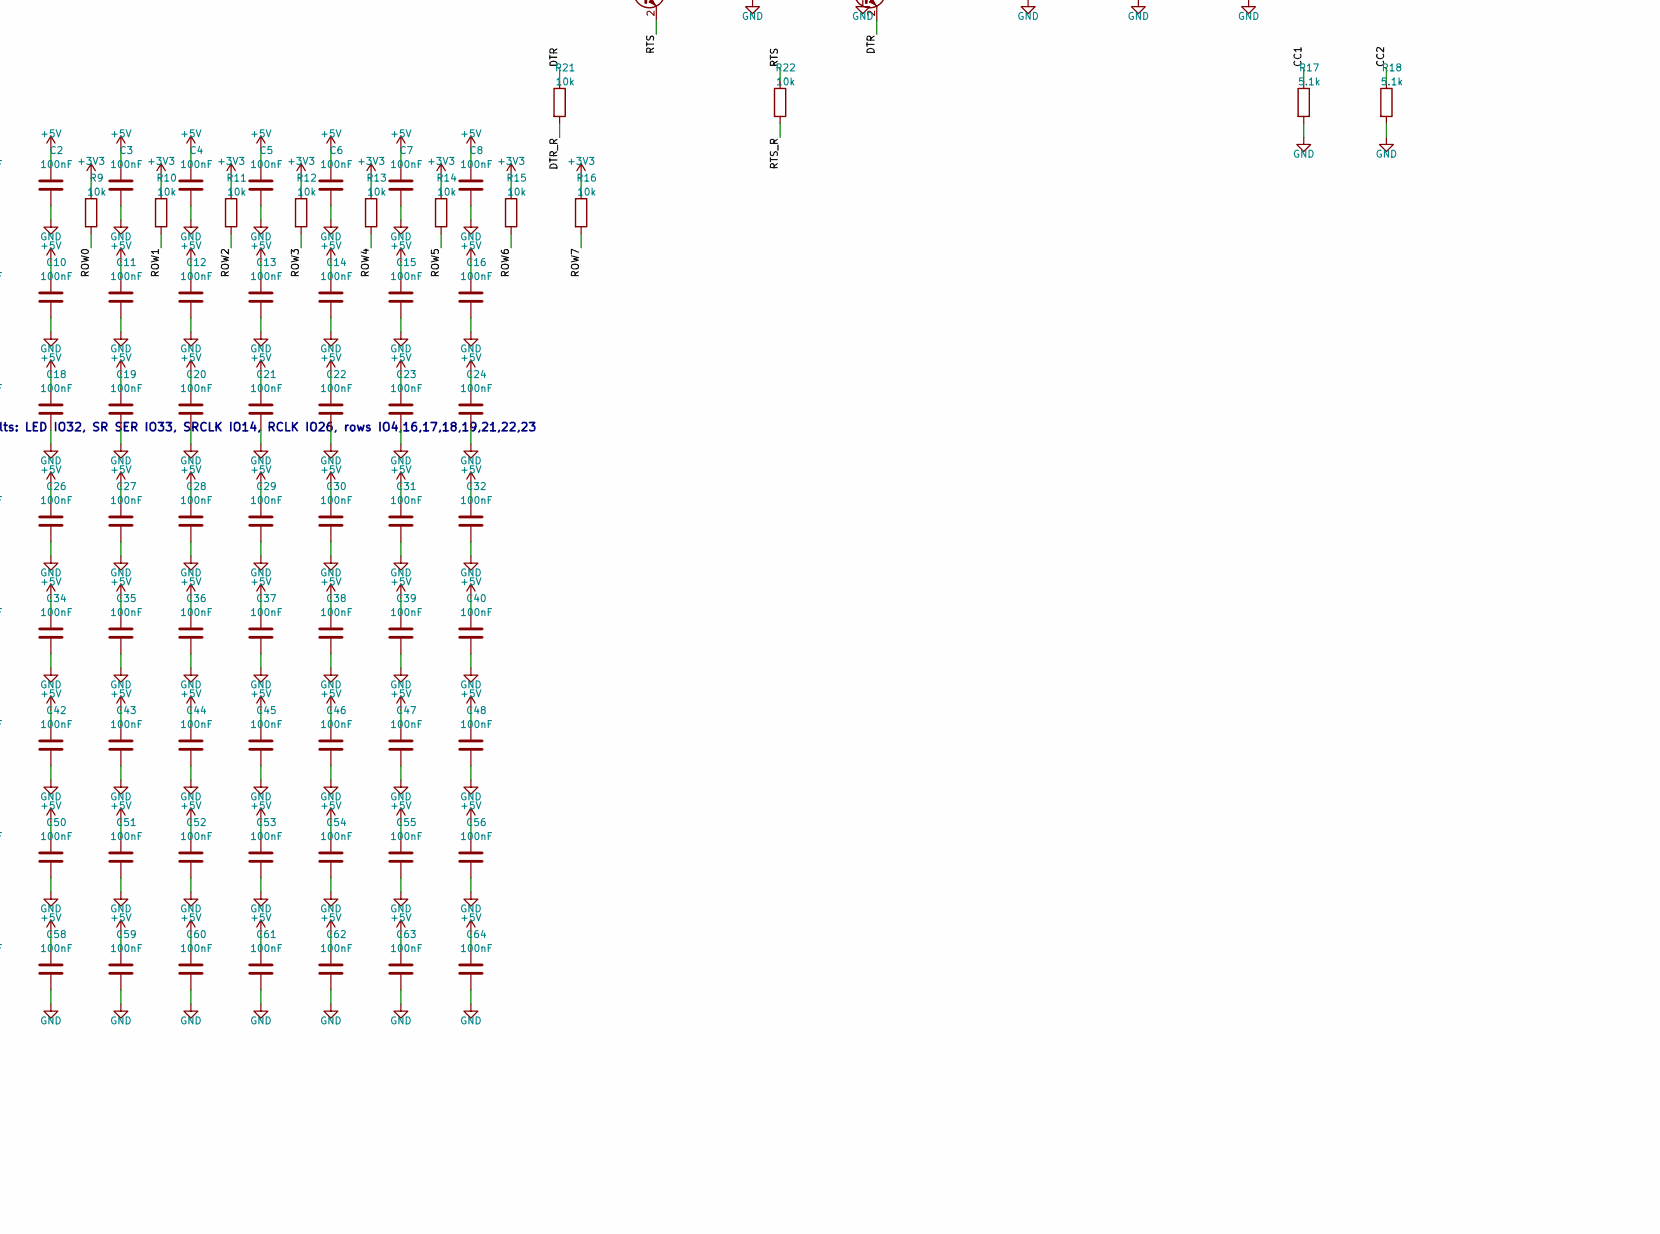
[picture p24: schematic openchess-board.kicad_sch, OpenChess PCB redesign - 8x8 Hall/WS2812B board (module var…, part in row 2, column 2]

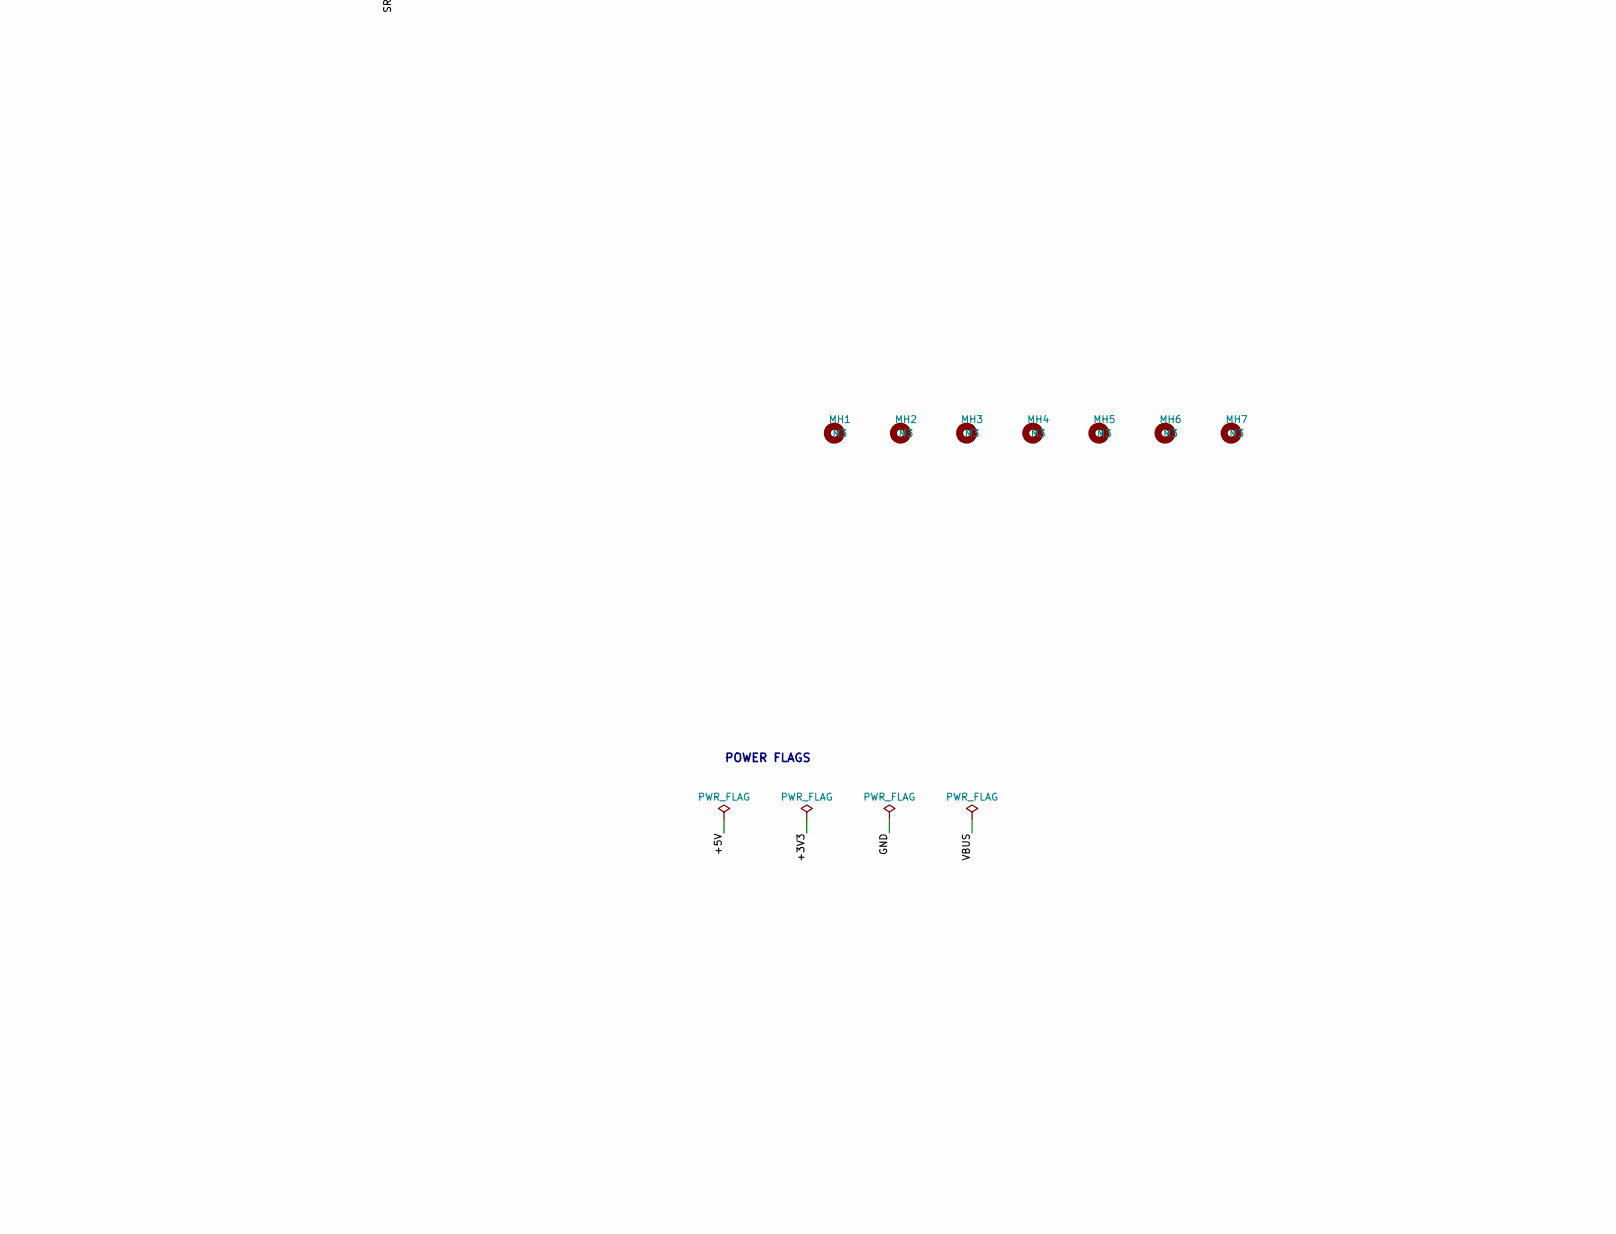
[picture p25: schematic openchess-board.kicad_sch, OpenChess PCB redesign - 8x8 Hall/WS2812B board (module var…, part in row 2, column 3]

Parts:
C1, C2, C3, C4, C5, C6, C7, C8, C9, C10, C11, C12, C13, C14, C15, C16, C17, C18, C19, C20, C21, C22, C23, C24, C25, C26, C27, C28, C29, C30, C31, C32, C33, C34, C35, C36, C37, C38, C39, C40, C41, C42, C43, C44, C45, C46, C47, C48, C49, C50, C51, C52, C53, C54, C55, C56, C57, C58, C59, C60, C61, C62, C63, C64: 100nF; C_0603_1608Metric; MPN CL10B104KB8NNNC; LCSC C14663
C65, C68, C69: 10uF; C_0805_2012Metric; LCSC C15850
C66, C71, C72, C73, C74: 100nF; C_0603_1608Metric; LCSC C14663
C67: 1uF; C_0603_1608Metric; LCSC C15849
C75, C76: 470uF 10V; CP_Elec_8x10; MPN 470uF/10V SMD 8x10
C77, C78, C79: 22uF; C_0805_2012Metric; LCSC C45783
D1, D2, D3, D4, D5, D6, D7, D8, D9, D10, D11, D12, D13, D14, D15, D16, D17, D18, D19, D20, D21, D22, D23, D24, D25, D26, D27, D28, D29, D30, D31, D32, D33, D34, D35, D36, D37, D38, D39, D40, D41, D42, D43, D44, D45, D46, D47, D48, D49, D50, D51, D52, D53, D54, D55, D56, D57, D58, D59, D60, D61, D62, D63, D64: WS2812B; LED_WS2812B_PLCC4_5.0x5.0mm_P3.2mm; MPN WS2812B-B/T; LCSC C2761795
DL1: PWR; LED_0603_1608Metric; LCSC C72043
F1: 3A PTC; Fuse_1812_4532Metric; MPN MF-MSMF300-2 / BSMD1812-300
H1, H2, H3, H4, H5, H6, H7, H8, H9, H10, H11, H12, H13, H14, H15, H16, H17, H18, H19, H20, H21, H22, H23, H24, H25, H26, H27, H28, H29, H30, H31, H32, H33, H34, H35, H36, H37, H38, H39, H40, H41, H42, H43, H44, H45, H46, H47, H48, H49, H50, H51, H52, H53, H54, H55, H56, H57, H58, H59, H60, H61, H62, H63, H64: HX3144ESO; SOT-23; MPN HX3144ESO
J1: USB-C; USB_C_Receptacle_HRO_TYPE-C-31-M-12; MPN TYPE-C-31-M-12; LCSC C165948
J2: 5V IN; JST_XH_B2B-XH-A_1x02_P2.50mm_Vertical; MPN B2B-XH-A; LCSC C158012
J5: BATTERY; JST_PH_B2B-PH-K_1x02_P2.00mm_Vertical; MPN B2B-PH-K-S; LCSC C131337
JP1: PWR SEL; PinHeader_1x03_P2.54mm_Vertical; MPN 1x3 header + jumper; LCSC C2337
L1: 1uH 4A; L_Taiyo-Yuden_NR-60xx; MPN NR6028T1R0N / CD63 1uH >=4A
MH1, MH2, MH3, MH4, MH5, MH6, MH7: M3; MountingHole_3.2mm_M3
Q1, Q2, Q3, Q4, Q5, Q6, Q7, Q8: S8550; SOT-23; MPN S8550; LCSC C2150
Q9, Q10: S8050; SOT-23; MPN S8050; LCSC C2146
R1, R2, R3, R4, R5, R6, R7, R8, R24: 1k; R_0603_1608Metric; LCSC C21190
R9, R10, R11, R12, R13, R14, R15, R16, R19, R20, R21, R22: 10k; R_0603_1608Metric; LCSC C25804
R17, R18: 5.1k; R_0603_1608Metric; LCSC C23186
R23: 330; R_0603_1608Metric; LCSC C23138
SW1: RESET; SW_SPST_TL3342; MPN TS-1187A-B-A-B; LCSC C318884
SW2: BOOT; SW_SPST_TL3342; MPN TS-1187A-B-A-B; LCSC C318884
SW3: PWR; SW_SPST_TL3342; MPN TS-1187A-B-A-B; LCSC C318884
U1: ESP32-WROOM-32E; ESP32-WROOM-32; MPN ESP32-WROOM-32E-N4; LCSC C701341
U2: AMS1117-3.3; SOT-223-3_TabPin2; MPN AMS1117-3.3; LCSC C6186
U3: CH340C; SOIC-16_3.9x9.9mm_P1.27mm; MPN CH340C; LCSC C84681
U4: 74HCT595; SOIC-16_3.9x9.9mm_P1.27mm; MPN SN74HCT595DR / 74HCT595D
U5: 74AHCT1G125; SOT-23-5; MPN SN74AHCT1G125DBVR
U6: IP5306; HSOP-8-1EP_3.9x4.9mm_P1.27mm_EP2.41x3.1mm_ThermalVias; MPN IP5306; LCSC C181692

Connections:
+3V3: C65.1, C66.1, C69.1, R9.1, R10.1, R11.1, R12.1, R13.1, R14.1, R15.1, R16.1, R19.1, R20.1, R24.1, U1.2 (VDD), U2.2 (VO)
+5V: C1.1, C2.1, C3.1, C4.1, C5.1, C6.1, C7.1, C8.1, C9.1, C10.1, C11.1, C12.1, C13.1, C14.1, C15.1, C16.1, C17.1, C18.1, C19.1, C20.1, C21.1, C22.1, C23.1, C24.1, C25.1, C26.1, C27.1, C28.1, C29.1, C30.1, C31.1, C32.1, C33.1, C34.1, C35.1, C36.1, C37.1, C38.1, C39.1, C40.1, C41.1, C42.1, C43.1, C44.1, C45.1, C46.1, C47.1, C48.1, C49.1, C50.1, C51.1, C52.1, C53.1, C54.1, C55.1, C56.1, C57.1, C58.1, C59.1, C60.1, C61.1, C62.1, C63.1, C64.1, C68.1, C71.1, C73.1, C74.1, C75.1, C76.1, D1.1 (VDD), D2.1 (VDD), D3.1 (VDD), D4.1 (VDD), D5.1 (VDD), D6.1 (VDD), D7.1 (VDD), D8.1 (VDD), D9.1 (VDD), D10.1 (VDD), D11.1 (VDD), D12.1 (VDD), D13.1 (VDD), D14.1 (VDD), D15.1 (VDD), D16.1 (VDD), D17.1 (VDD), D18.1 (VDD), D19.1 (VDD), D20.1 (VDD), D21.1 (VDD), D22.1 (VDD), D23.1 (VDD), D24.1 (VDD), D25.1 (VDD), D26.1 (VDD), D27.1 (VDD), D28.1 (VDD), D29.1 (VDD), D30.1 (VDD), D31.1 (VDD), D32.1 (VDD), D33.1 (VDD), D34.1 (VDD), D35.1 (VDD), D36.1 (VDD), D37.1 (VDD), D38.1 (VDD), D39.1 (VDD), D40.1 (VDD), D41.1 (VDD), D42.1 (VDD), D43.1 (VDD), D44.1 (VDD), D45.1 (VDD), D46.1 (VDD), D47.1 (VDD), D48.1 (VDD), D49.1 (VDD), D50.1 (VDD), D51.1 (VDD), D52.1 (VDD), D53.1 (VDD), D54.1 (VDD), D55.1 (VDD), D56.1 (VDD), D57.1 (VDD), D58.1 (VDD), D59.1 (VDD), D60.1 (VDD), D61.1 (VDD), D62.1 (VDD), D63.1 (VDD), D64.1 (VDD), J2.1, JP1.2, Q1.2 (E), Q2.2 (E), Q3.2 (E), Q4.2 (E), Q5.2 (E), Q6.2 (E), Q7.2 (E), Q8.2 (E), U2.3 (VI), U3.16 (VCC), U4.10 (~SRCLR), U4.16 (VCC), U5.5 (VCC)
BAT: C78.1, J5.1, L1.2, U6.6 (BAT)
CC1: J1.A5 (CC1), R17.1
CC2: J1.B5 (CC2), R18.1
CH_V3: C72.1, U3.4 (V3)
COL0: H1.1 (VCC), H9.1 (VCC), H17.1 (VCC), H25.1 (VCC), H33.1 (VCC), H41.1 (VCC), H49.1 (VCC), H57.1 (VCC), Q1.3 (C)
COL1: H2.1 (VCC), H10.1 (VCC), H18.1 (VCC), H26.1 (VCC), H34.1 (VCC), H42.1 (VCC), H50.1 (VCC), H58.1 (VCC), Q2.3 (C)
COL2: H3.1 (VCC), H11.1 (VCC), H19.1 (VCC), H27.1 (VCC), H35.1 (VCC), H43.1 (VCC), H51.1 (VCC), H59.1 (VCC), Q3.3 (C)
COL3: H4.1 (VCC), H12.1 (VCC), H20.1 (VCC), H28.1 (VCC), H36.1 (VCC), H44.1 (VCC), H52.1 (VCC), H60.1 (VCC), Q4.3 (C)
COL4: H5.1 (VCC), H13.1 (VCC), H21.1 (VCC), H29.1 (VCC), H37.1 (VCC), H45.1 (VCC), H53.1 (VCC), H61.1 (VCC), Q5.3 (C)
COL5: H6.1 (VCC), H14.1 (VCC), H22.1 (VCC), H30.1 (VCC), H38.1 (VCC), H46.1 (VCC), H54.1 (VCC), H62.1 (VCC), Q6.3 (C)
COL6: H7.1 (VCC), H15.1 (VCC), H23.1 (VCC), H31.1 (VCC), H39.1 (VCC), H47.1 (VCC), H55.1 (VCC), H63.1 (VCC), Q7.3 (C)
COL7: H8.1 (VCC), H16.1 (VCC), H24.1 (VCC), H32.1 (VCC), H40.1 (VCC), H48.1 (VCC), H56.1 (VCC), H64.1 (VCC), Q8.3 (C)
DTR: Q10.2 (E), R21.1, U3.13 (~DTR)
DTR_R: Q9.1 (B), R21.2
EN: C67.1, Q9.3 (C), R19.2, SW1.1, U1.3 (EN)
GND: C1.2, C2.2, C3.2, C4.2, C5.2, C6.2, C7.2, C8.2, C9.2, C10.2, C11.2, C12.2, C13.2, C14.2, C15.2, C16.2, C17.2, C18.2, C19.2, C20.2, C21.2, C22.2, C23.2, C24.2, C25.2, C26.2, C27.2, C28.2, C29.2, C30.2, C31.2, C32.2, C33.2, C34.2, C35.2, C36.2, C37.2, C38.2, C39.2, C40.2, C41.2, C42.2, C43.2, C44.2, C45.2, C46.2, C47.2, C48.2, C49.2, C50.2, C51.2, C52.2, C53.2, C54.2, C55.2, C56.2, C57.2, C58.2, C59.2, C60.2, C61.2, C62.2, C63.2, C64.2, C65.2, C66.2, C67.2, C68.2, C69.2, C71.2, C72.2, C73.2, C74.2, C75.2, C76.2, C77.2, C78.2, C79.2, D1.3 (VSS), D2.3 (VSS), D3.3 (VSS), D4.3 (VSS), D5.3 (VSS), D6.3 (VSS), D7.3 (VSS), D8.3 (VSS), D9.3 (VSS), D10.3 (VSS), D11.3 (VSS), D12.3 (VSS), D13.3 (VSS), D14.3 (VSS), D15.3 (VSS), D16.3 (VSS), D17.3 (VSS), D18.3 (VSS), D19.3 (VSS), D20.3 (VSS), D21.3 (VSS), D22.3 (VSS), D23.3 (VSS), D24.3 (VSS), D25.3 (VSS), D26.3 (VSS), D27.3 (VSS), D28.3 (VSS), D29.3 (VSS), D30.3 (VSS), D31.3 (VSS), D32.3 (VSS), D33.3 (VSS), D34.3 (VSS), D35.3 (VSS), D36.3 (VSS), D37.3 (VSS), D38.3 (VSS), D39.3 (VSS), D40.3 (VSS), D41.3 (VSS), D42.3 (VSS), D43.3 (VSS), D44.3 (VSS), D45.3 (VSS), D46.3 (VSS), D47.3 (VSS), D48.3 (VSS), D49.3 (VSS), D50.3 (VSS), D51.3 (VSS), D52.3 (VSS), D53.3 (VSS), D54.3 (VSS), D55.3 (VSS), D56.3 (VSS), D57.3 (VSS), D58.3 (VSS), D59.3 (VSS), D60.3 (VSS), D61.3 (VSS), D62.3 (VSS), D63.3 (VSS), D64.3 (VSS), DL1.1 (K), H1.3 (GND), H2.3 (GND), H3.3 (GND), H4.3 (GND), H5.3 (GND), H6.3 (GND), H7.3 (GND), H8.3 (GND), H9.3 (GND), H10.3 (GND), H11.3 (GND), H12.3 (GND), H13.3 (GND), H14.3 (GND), H15.3 (GND), H16.3 (GND), H17.3 (GND), H18.3 (GND), H19.3 (GND), H20.3 (GND), H21.3 (GND), H22.3 (GND), H23.3 (GND), H24.3 (GND), H25.3 (GND), H26.3 (GND), H27.3 (GND), H28.3 (GND), H29.3 (GND), H30.3 (GND), H31.3 (GND), H32.3 (GND), H33.3 (GND), H34.3 (GND), H35.3 (GND), H36.3 (GND), H37.3 (GND), H38.3 (GND), H39.3 (GND), H40.3 (GND), H41.3 (GND), H42.3 (GND), H43.3 (GND), H44.3 (GND), H45.3 (GND), H46.3 (GND), H47.3 (GND), H48.3 (GND), H49.3 (GND), H50.3 (GND), H51.3 (GND), H52.3 (GND), H53.3 (GND), H54.3 (GND), H55.3 (GND), H56.3 (GND), H57.3 (GND), H58.3 (GND), H59.3 (GND), H60.3 (GND), H61.3 (GND), H62.3 (GND), H63.3 (GND), H64.3 (GND), J1.A1 (GND), J1.A12 (GND), J1.B1 (GND), J1.B12 (GND), J1.S1 (SHIELD), J2.2, J5.2, R17.2, R18.2, SW1.2, SW2.2, SW3.2, U1.1 (GND), U1.15 (GND), U1.38 (GND), U1.39 (GND), U2.1 (GND), U3.1 (GND), U4.8 (GND), U4.13 (~OE), U5.1, U5.3 (GND), U6.9 (GND)
IO0: Q10.3 (C), R20.2, SW2.1, U1.25 (IO0)
IO14: U1.13 (IO14), U4.11 (SRCLK)
IO26: U1.11 (IO26), U4.12 (RCLK)
IO32: U1.8 (IO32), U5.2
IO33: U1.9 (IO33), U4.14 (SER)
KEY: SW3.1, U6.5 (KEY)
LED1: D1.2 (DOUT), D2.4 (DIN)
LED2: D2.2 (DOUT), D3.4 (DIN)
LED3: D3.2 (DOUT), D4.4 (DIN)
LED4: D4.2 (DOUT), D5.4 (DIN)
LED5: D5.2 (DOUT), D6.4 (DIN)
LED6: D6.2 (DOUT), D7.4 (DIN)
LED7: D7.2 (DOUT), D8.4 (DIN)
LED8: D8.2 (DOUT), D9.4 (DIN)
LED9: D9.2 (DOUT), D10.4 (DIN)
LED10: D10.2 (DOUT), D11.4 (DIN)
LED11: D11.2 (DOUT), D12.4 (DIN)
LED12: D12.2 (DOUT), D13.4 (DIN)
LED13: D13.2 (DOUT), D14.4 (DIN)
LED14: D14.2 (DOUT), D15.4 (DIN)
LED15: D15.2 (DOUT), D16.4 (DIN)
LED16: D16.2 (DOUT), D17.4 (DIN)
LED17: D17.2 (DOUT), D18.4 (DIN)
LED18: D18.2 (DOUT), D19.4 (DIN)
LED19: D19.2 (DOUT), D20.4 (DIN)
LED20: D20.2 (DOUT), D21.4 (DIN)
LED21: D21.2 (DOUT), D22.4 (DIN)
LED22: D22.2 (DOUT), D23.4 (DIN)
LED23: D23.2 (DOUT), D24.4 (DIN)
LED24: D24.2 (DOUT), D25.4 (DIN)
LED25: D25.2 (DOUT), D26.4 (DIN)
LED26: D26.2 (DOUT), D27.4 (DIN)
LED27: D27.2 (DOUT), D28.4 (DIN)
LED28: D28.2 (DOUT), D29.4 (DIN)
LED29: D29.2 (DOUT), D30.4 (DIN)
LED30: D30.2 (DOUT), D31.4 (DIN)
LED31: D31.2 (DOUT), D32.4 (DIN)
LED32: D32.2 (DOUT), D33.4 (DIN)
LED33: D33.2 (DOUT), D34.4 (DIN)
LED34: D34.2 (DOUT), D35.4 (DIN)
LED35: D35.2 (DOUT), D36.4 (DIN)
LED36: D36.2 (DOUT), D37.4 (DIN)
LED37: D37.2 (DOUT), D38.4 (DIN)
LED38: D38.2 (DOUT), D39.4 (DIN)
LED39: D39.2 (DOUT), D40.4 (DIN)
LED40: D40.2 (DOUT), D41.4 (DIN)
LED41: D41.2 (DOUT), D42.4 (DIN)
LED42: D42.2 (DOUT), D43.4 (DIN)
LED43: D43.2 (DOUT), D44.4 (DIN)
LED44: D44.2 (DOUT), D45.4 (DIN)
LED45: D45.2 (DOUT), D46.4 (DIN)
LED46: D46.2 (DOUT), D47.4 (DIN)
LED47: D47.2 (DOUT), D48.4 (DIN)
LED48: D48.2 (DOUT), D49.4 (DIN)
LED49: D49.2 (DOUT), D50.4 (DIN)
LED50: D50.2 (DOUT), D51.4 (DIN)
LED51: D51.2 (DOUT), D52.4 (DIN)
LED52: D52.2 (DOUT), D53.4 (DIN)
LED53: D53.2 (DOUT), D54.4 (DIN)
LED54: D54.2 (DOUT), D55.4 (DIN)
LED55: D55.2 (DOUT), D56.4 (DIN)
LED56: D56.2 (DOUT), D57.4 (DIN)
LED57: D57.2 (DOUT), D58.4 (DIN)
LED58: D58.2 (DOUT), D59.4 (DIN)
LED59: D59.2 (DOUT), D60.4 (DIN)
LED60: D60.2 (DOUT), D61.4 (DIN)
LED61: D61.2 (DOUT), D62.4 (DIN)
LED62: D62.2 (DOUT), D63.4 (DIN)
LED63: D63.2 (DOUT), D64.4 (DIN)
LED_DATA: D1.4 (DIN), R23.2
LED_DATA_5V: R23.1, U5.4
LX: L1.1, U6.7 (L1)
PWRLED: DL1.2 (A), R24.2
ROW0: H1.2 (OUT), H2.2 (OUT), H3.2 (OUT), H4.2 (OUT), H5.2 (OUT), H6.2 (OUT), H7.2 (OUT), H8.2 (OUT), R9.2, U1.26 (IO4)
ROW1: H9.2 (OUT), H10.2 (OUT), H11.2 (OUT), H12.2 (OUT), H13.2 (OUT), H14.2 (OUT), H15.2 (OUT), H16.2 (OUT), R10.2, U1.27 (IO16)
ROW2: H17.2 (OUT), H18.2 (OUT), H19.2 (OUT), H20.2 (OUT), H21.2 (OUT), H22.2 (OUT), H23.2 (OUT), H24.2 (OUT), R11.2, U1.28 (IO17)
ROW3: H25.2 (OUT), H26.2 (OUT), H27.2 (OUT), H28.2 (OUT), H29.2 (OUT), H30.2 (OUT), H31.2 (OUT), H32.2 (OUT), R12.2, U1.30 (IO18)
ROW4: H33.2 (OUT), H34.2 (OUT), H35.2 (OUT), H36.2 (OUT), H37.2 (OUT), H38.2 (OUT), H39.2 (OUT), H40.2 (OUT), R13.2, U1.31 (IO19)
ROW5: H41.2 (OUT), H42.2 (OUT), H43.2 (OUT), H44.2 (OUT), H45.2 (OUT), H46.2 (OUT), H47.2 (OUT), H48.2 (OUT), R14.2, U1.33 (IO21)
ROW6: H49.2 (OUT), H50.2 (OUT), H51.2 (OUT), H52.2 (OUT), H53.2 (OUT), H54.2 (OUT), H55.2 (OUT), H56.2 (OUT), R15.2, U1.36 (IO22)
ROW7: H57.2 (OUT), H58.2 (OUT), H59.2 (OUT), H60.2 (OUT), H61.2 (OUT), H62.2 (OUT), H63.2 (OUT), H64.2 (OUT), R16.2, U1.37 (IO23)
RTS: Q9.2 (E), R22.1, U3.14 (~RTS)
RTS_R: Q10.1 (B), R22.2
RXD0: U1.34 (RXD0/IO3), U3.2 (TXD)
SRQ0: R1.1, U4.15 (QA)
SRQ0_R: Q1.1 (B), R1.2
SRQ1: R2.1, U4.1 (QB)
SRQ1_R: Q2.1 (B), R2.2
SRQ2: R3.1, U4.2 (QC)
SRQ2_R: Q3.1 (B), R3.2
SRQ3: R4.1, U4.3 (QD)
SRQ3_R: Q4.1 (B), R4.2
SRQ4: R5.1, U4.4 (QE)
SRQ4_R: Q5.1 (B), R5.2
SRQ5: R6.1, U4.5 (QF)
SRQ5_R: Q6.1 (B), R6.2
SRQ6: R7.1, U4.6 (QG)
SRQ6_R: Q7.1 (B), R7.2
SRQ7: R8.1, U4.7 (QH)
SRQ7_R: Q8.1 (B), R8.2
TXD0: U1.35 (TXD0/IO1), U3.3 (RXD)
USB_D+: J1.A6 (D+), J1.B6 (D+), U3.5 (UD+)
USB_D-: J1.A7 (D-), J1.B7 (D-), U3.6 (UD-)
VBOOST: C79.1, JP1.3, U6.8 (VOUT)
VBUS: F1.1, J1.A4 (VBUS), J1.A9 (VBUS), J1.B4 (VBUS), J1.B9 (VBUS)
VUSB5: C77.1, F1.2, JP1.1, U6.1 (VIN)

Notes on the sheet:
HALL SENSOR MATRIX (columns = switched +5V via PNP, rows = open-collector OUT wired-OR, 10k pull-up to 3V3)
WS2812B LED CHAIN (serpentine a1->h1, h2->a2, ... ; each LED has a 100nF cap)
CONTROLLER (ESP32-WROOM-32E, CH340C USB-UART, AMS1117-3.3, 74HCT595 column driver, 74AHCT1G125 LED level shifter)
OPTIONAL BATTERY: IP5306 charges a 1S Li-ion from VUSB5 and boosts it to 5 V. JP1 1-2 = USB direct, 2-3 = battery/boost.
Column drivers: 74HCT595 Qn -> 1k -> PNP base; emitter +5V; collector = COLn (switched +5V to 8 sensors). Firmware: SR_INVERT_OUTPUTS = PNP
ESP32 GPIO map = OpenChess defaults: LED IO32, SR SER IO33, SRCLK IO14, RCLK IO26, rows IO4,16,17,18,19,21,22,23
POWER FLAGS

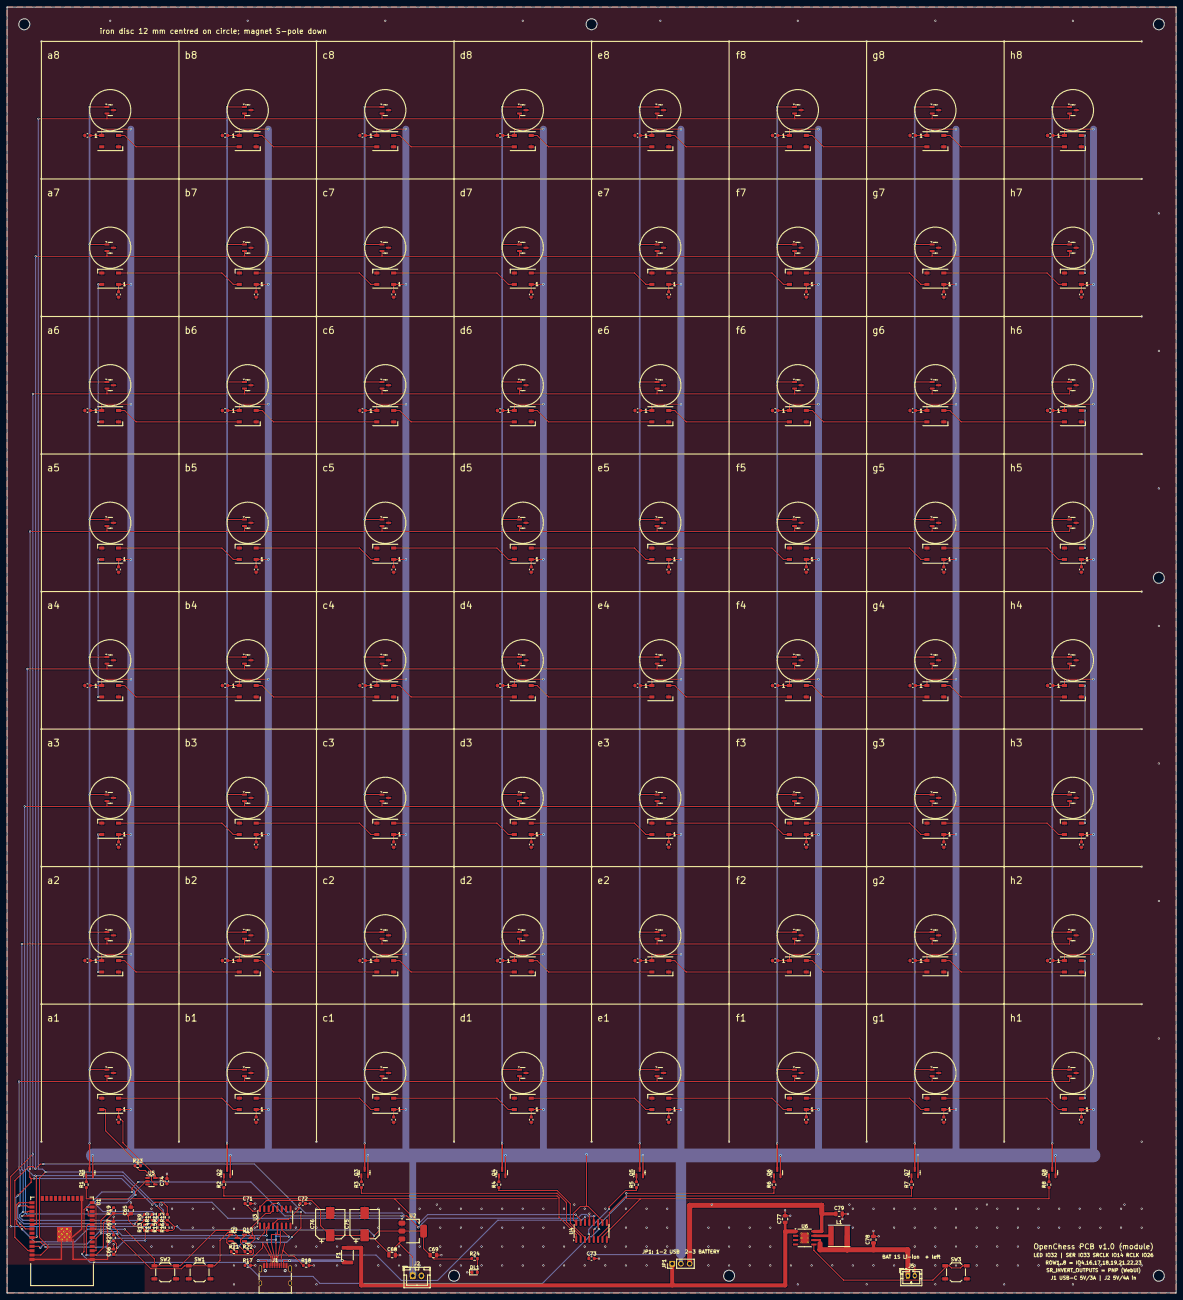
[picture p26: board openchess-board.kicad_pcb from above]

Board: 2 copper layers, 340.0 x 374.0 mm, 263 parts (0 on the bottom side), 124 nets.
