Fabienrortais/cz/(commit log)

2026-10-19 Add OpenChess PCB redesign generators, schematic and audit
    Audit of joojoooo/OpenChess (firmware + hand-wired hardware) and a
    complete single-PCB redesign that stays compatible with the upstream
    firmware: 8x8 SOT-23 Hall switches + WS2812B, 74HCT595/PNP column
    drivers, ESP32-WROOM-32E, CH340C, USB-C power. Everything is generated
    from tools/design.py (KiCad 7 schematic via S-expressions, PCB via the
    pcbnew API with scripted matrix routing, Freerouting for the strip).
    Claude-Session: https://claude.ai/code/session_01BYqUw5RUauFb8joYQgSgKZ
    [openchess-board.kicad_sch]
2026-10-19 Normalize CPL rotations and group BOM descriptions
    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
2026-10-19 Add generated PCB (matrix pre-routed) and BOM/CPL exports
    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
    [openchess-board-bom-jlcpcb.csv, openchess-board.kicad_pcb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]
2026-10-19 Make the generators work with KiCad 7 through 10
    Library paths from KiCad env vars / platform defaults, netclass and LSET API
    fallbacks, kicad-cli DRC when available, build.sh python detection.
    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
2026-10-19 Use an A2 page so plots contain the whole board; add previews
    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
    [openchess-board.kicad_pcb]
2026-10-19 Pre-route USB-C escape and VBUS, stitch strip ground, add SES importer
    KiCad 7 cannot import a Specctra session headless, so tools/ses_import.py
    reads the Freerouting .ses directly. Also trims bus ends, cleans dangling
    autorouter tails and solid-connects USB-C GND pads to the pour.
    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
    [openchess-board.kicad_pcb]
2026-10-19 Add nodemcu variant: sockets for a 38-pin ESP32 dev board
    OPENCHESS_VARIANT=nodemcu replaces the soldered ESP32 module, CH340C, LDO
    and buttons with two 19-pin sockets (NodeMCU-32S / DevKitC pin order,
    row spacing parametric) and a taller strip; outputs go to *-nodemcu dirs.
    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
    [openchess-board-nodemcu.dsn, openchess-board-nodemcu.kicad_pcb, openchess-board-nodemcu.kicad_sch]
2026-10-19 Ignore the whole build directory
    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
    [openchess-board-nodemcu.dsn]
2026-10-19 Add GND island repair, router clearance margin, T-junction-aware tail cleanup
    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
    [openchess-board-nodemcu.kicad_pcb, openchess-board.kicad_pcb]
2026-10-19 nodemcu: pre-route GND stubs for the socket GND pins
    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
    [openchess-board-nodemcu.kicad_pcb]
2026-10-19 Pre-route 74HCT595 OE ground via; router margin 0.02 mm; GND repair adds pad stubs
    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
    [openchess-board-nodemcu.kicad_pcb, openchess-board.kicad_pcb]
2026-10-19 GND repair: island bridging + per-pad vias before routing; nodemcu manufacturing files
    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
    [openchess-board-nodemcu-B_Cu.gbl, openchess-board-nodemcu-B_Mask.gbs, openchess-board-nodemcu-B_Paste.gbp, openchess-board-nodemcu-B_Silkscreen.gbo, openchess-board-nodemcu-Edge_Cuts.gm1, openchess-board-nodemcu-F_Cu.gtl, openchess-board-nodemcu-F_Mask.gts, openchess-board-nodemcu-F_Paste.gtp]
2026-10-19 module: pre-route ESP32 GND pins to the thermal pad; repair uses exact track distances
    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
    [openchess-board.kicad_pcb]
2026-10-20 Module variant: routed, DRC-clean board and manufacturing files; net-level reroute tool
    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
    [openchess-board-B_Cu.gbl, openchess-board-B_Mask.gbs, openchess-board-B_Paste.gbp, openchess-board-B_Silkscreen.gbo, openchess-board-Edge_Cuts.gm1, openchess-board-F_Cu.gtl, openchess-board-F_Mask.gts, openchess-board-F_Paste.gtp]
2026-10-20 nodemcu: regenerated pre-route board (routing in progress)
    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
    [openchess-board-nodemcu.kicad_pcb]
2026-10-20 nodemcu: regenerated board for capped routing run
    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
    [openchess-board-nodemcu.kicad_pcb]
2026-10-20 NodeMCU variant: routed, DRC-clean board and manufacturing files
    build.sh: default 12 router passes (30 passes can loop on this strip).
    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
    [openchess-board-nodemcu-B_Cu.gbl, openchess-board-nodemcu-B_Mask.gbs, openchess-board-nodemcu-B_Paste.gbp, openchess-board-nodemcu-B_Silkscreen.gbo, openchess-board-nodemcu-Edge_Cuts.gm1, openchess-board-nodemcu-F_Cu.gtl, openchess-board-nodemcu-F_Mask.gts, openchess-board-nodemcu-F_Paste.gtp]
2026-10-21 Add parametric printable enclosure (OpenSCAD) generated from design.py
    Top plate in 4 quadrants (disc pockets, LED light pockets, grooves, engraved
    coordinates), tray in 4 pieces, controller-strip cover in 2 pieces; all fit a
    256 mm bed.
    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
    [enc_params.scad, enclosure.scad]
2026-10-21 Add rendered enclosure STLs for both variants; README enclosure section
    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
    [enc_params.scad, openchess-board-cover_0.stl, openchess-board-cover_1.stl, openchess-board-nodemcu-cover_0.stl, openchess-board-nodemcu-cover_1.stl, openchess-board-nodemcu-top_q00.stl, openchess-board-nodemcu-top_q01.stl, openchess-board-nodemcu-top_q10.stl]
2026-10-21 Add optional IP5306 battery charger/boost block with power-select jumper
    Fuse -> JP1 pin 1 / IP5306 VIN; IP5306 VOUT -> JP1 pin 3; JP1 pin 2 -> 5V bus.
    JST-PH battery connector, key button, 1 uH inductor, 3x 22 uF. Wide power
    paths pre-routed; enclosure cover gets openings for J5, SW3 and JP1.
    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
    [enc_params.scad, enclosure.scad, openchess-board-nodemcu.kicad_pcb, openchess-board-nodemcu.kicad_sch, openchess-board.kicad_pcb, openchess-board.kicad_sch]
2026-10-21 Both variants routed and DRC-clean with the battery block; manufacturing files and enclosure STLs regenerated
    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
    [enc_params.scad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]
2026-10-24 Pre-order checklist: confirmed LCSC numbers, fixed PNP/NPN part numbers, no-battery BOM/CPL variants
    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
    [openchess-board-bom-jlcpcb-nobattery.csv, openchess-board-bom-jlcpcb.csv, openchess-board-nodemcu-bom-jlcpcb-nobattery.csv, openchess-board-nodemcu-bom-jlcpcb.csv, openchess-board-nodemcu.kicad_sch, openchess-board.kicad_sch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]
